PCModder803/fw16-mxm-adapter/mechanical/README.md

# Printed bottom frame mockup (not for print yet)

- `printed_frame_mockup.step`: the frame as a solid, in the coordinates of Framework's graphics-module
  assembly, so it overlays `FW_GRAPHICS_MODULE_REF_00-1.stp`.
- `printed_frame_mockup.stl`: the same, meshed (binary, watertight).
- `preview/`: renders, with the adapter board (green), MXM socket (red), ear pads (yellow) and card
  (blue) where shown.

They are generated by `../generate_frame.py`; see `../FRAME_PLAN.md` for what was changed, the fit
check, and what to check before printing.

## Licence and credit

These files are a modified version of the graphics-module bottom frame (IFGP6_DIS_FRAME_BTM) from
Framework Computer's FrameworkComputer/ExpansionBay repository, licensed under CC BY 4.0
(https://creativecommons.org/licenses/by/4.0/). Changes:
- lengthened by 3.7 mm at the rear over the full width (the rear wall, its vents and the corners moved
  back unchanged);
- the cover-screw bosses moved;
- the rear-wall ribs trimmed;
- two frame pins and a small front-left lip removed;
- one locating pin cut flush.

These files are licensed CC BY 4.0, not under the repository's CERN-OHL-S. Framework Computer does not
endorse this project.
