PCModder803/fw16-mxm-adapter/mechanical/preview/frame_iso.png

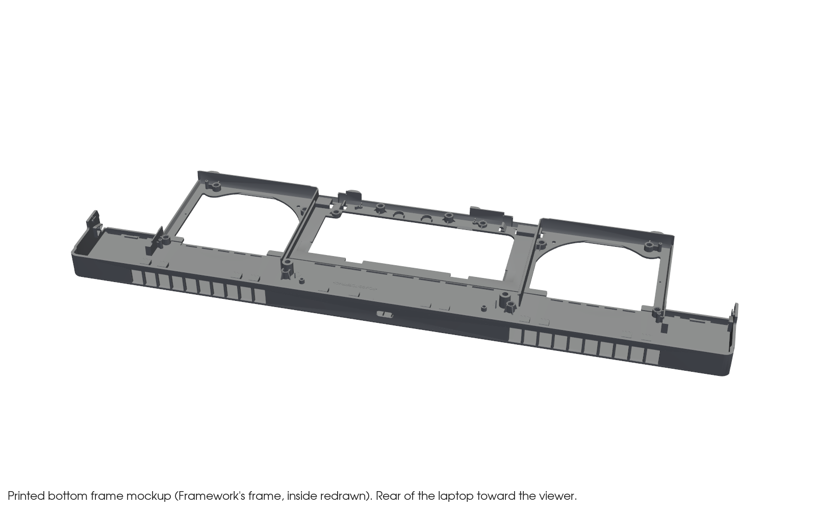
mechanical/preview/frame_iso.png
