PCModder803/fw16-mxm-adapter/mechanical/preview/frame_iso_with_card.png

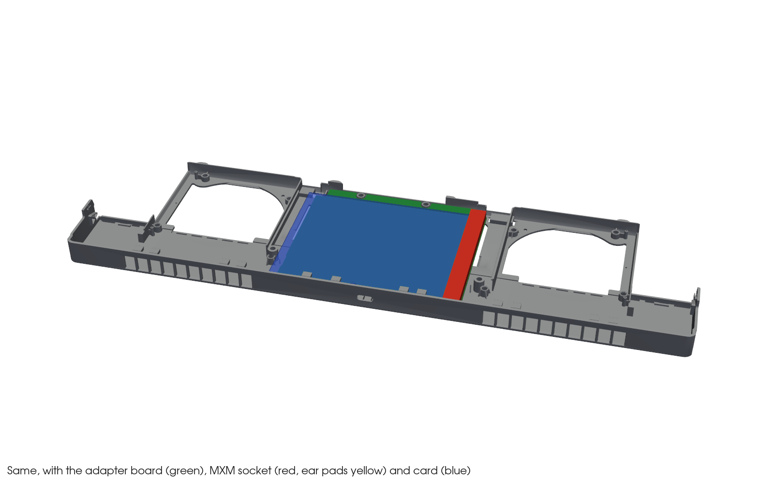
mechanical/preview/frame_iso_with_card.png
