PCModder803/fw16-mxm-adapter/mechanical/preview/frame_top.png

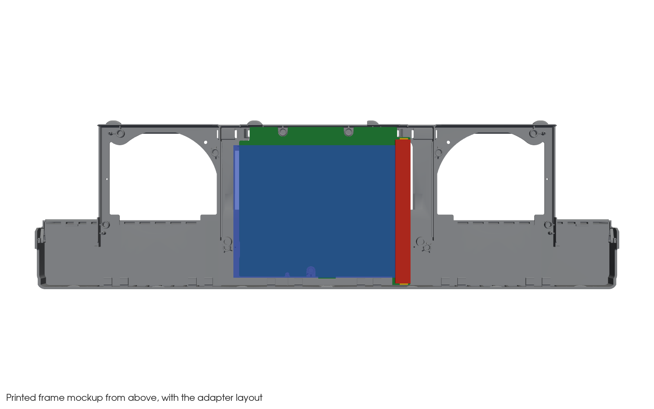
mechanical/preview/frame_top.png
