PCModder803/fw16-mxm-adapter/mechanical/preview/rear_left.png

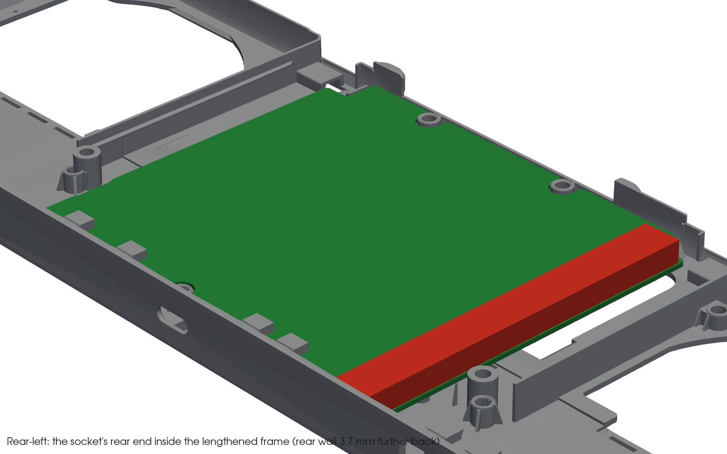
mechanical/preview/rear_left.png
