PCModder803/fw16-mxm-adapter/mechanical/preview/rear_outside.png

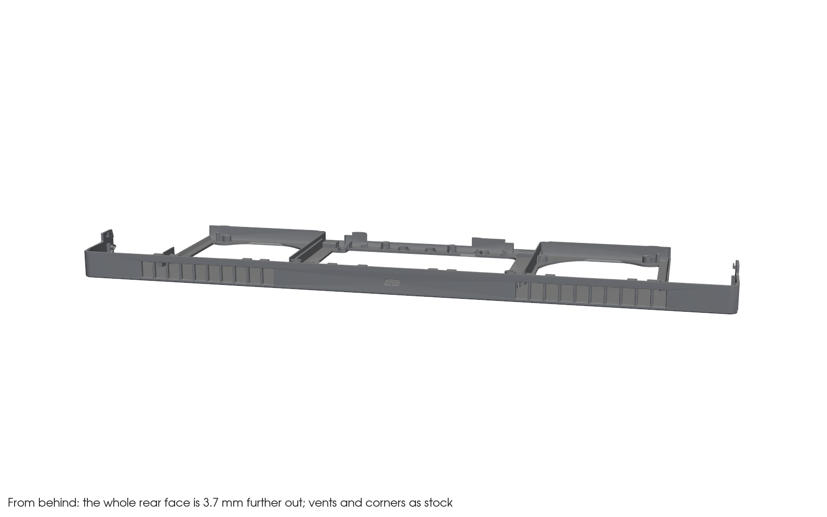
mechanical/preview/rear_outside.png
