PCModder803/fw16-mxm-adapter/reference/card_photos/efxdp1_riser_holes_labeled.jpg

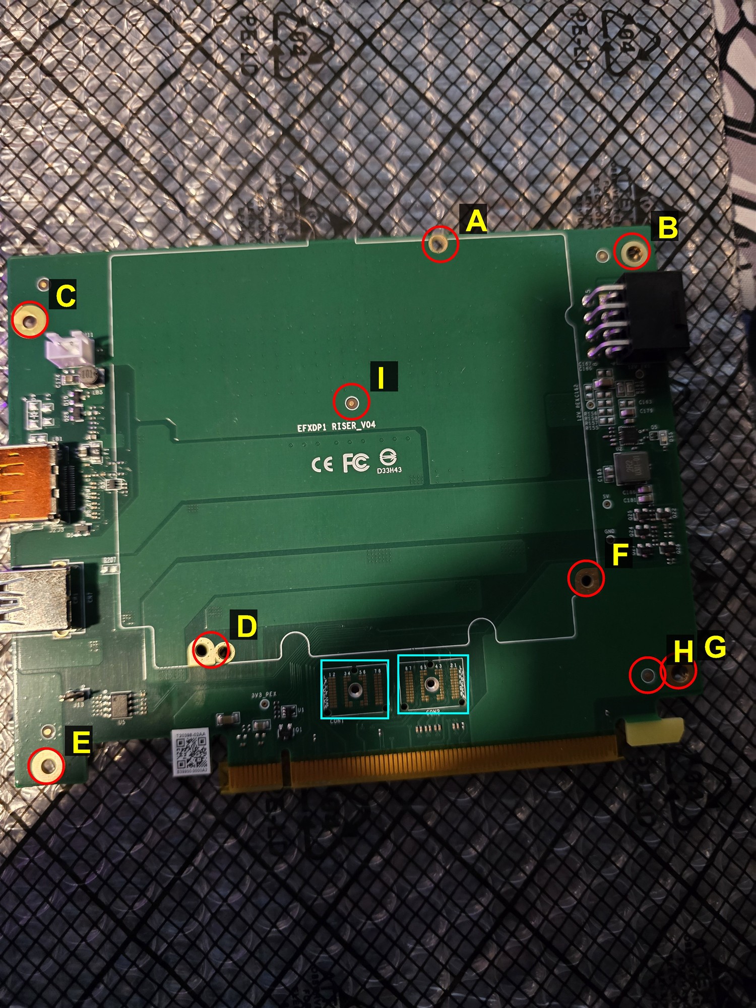
reference/card_photos/efxdp1_riser_holes_labeled.jpg
