PCModder803/fw16-mxm-adapter/reference/card_photos/xvision_rx6600xt_back.jpg

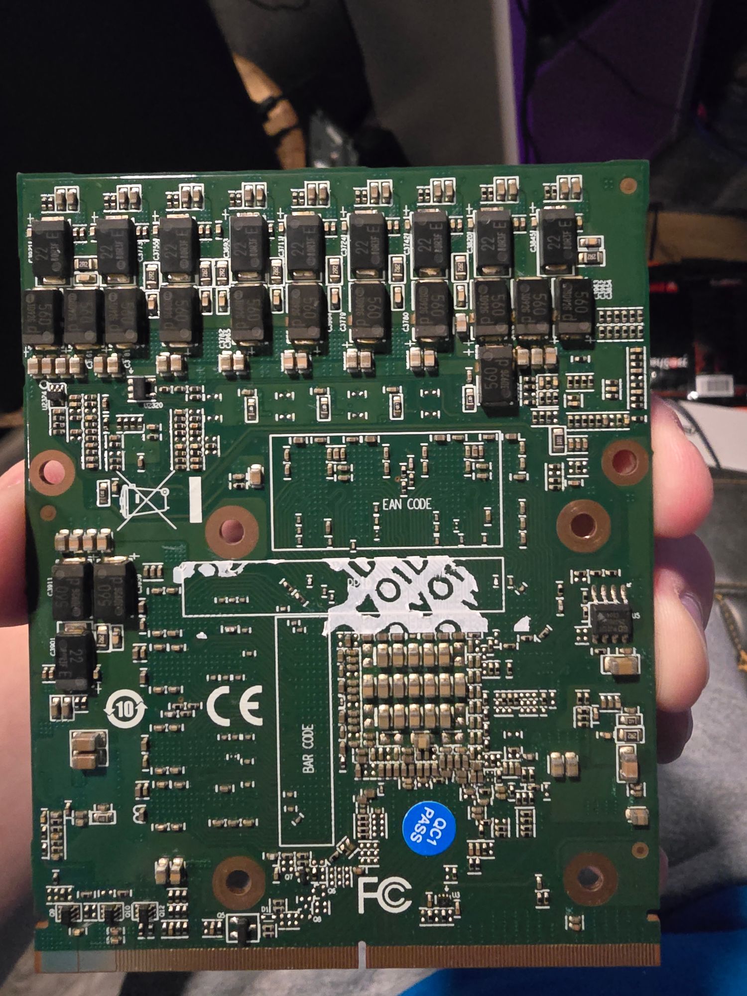
reference/card_photos/xvision_rx6600xt_back.jpg
