PCModder803/fw16-mxm-adapter/mechanical/printed_frame_mockup.step

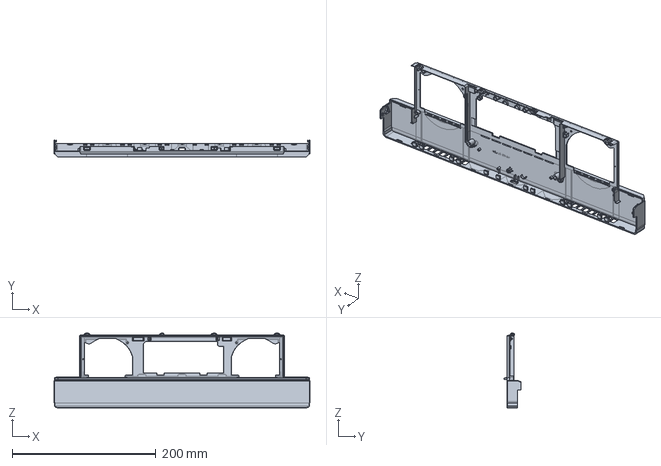
[picture p14: CAD file, 2026-11-12]
mechanical/printed_frame_mockup.step
356.6 x 24.1 x 104.0 mm
