PCModder803/fw16-mxm-adapter/(list of files, cad)

Other CAD files:
mechanical/printed_frame_mockup.stl
