PCModder803/fw16-mxm-adapter/fw16_mxm_adapter_pcb_draft.pdf

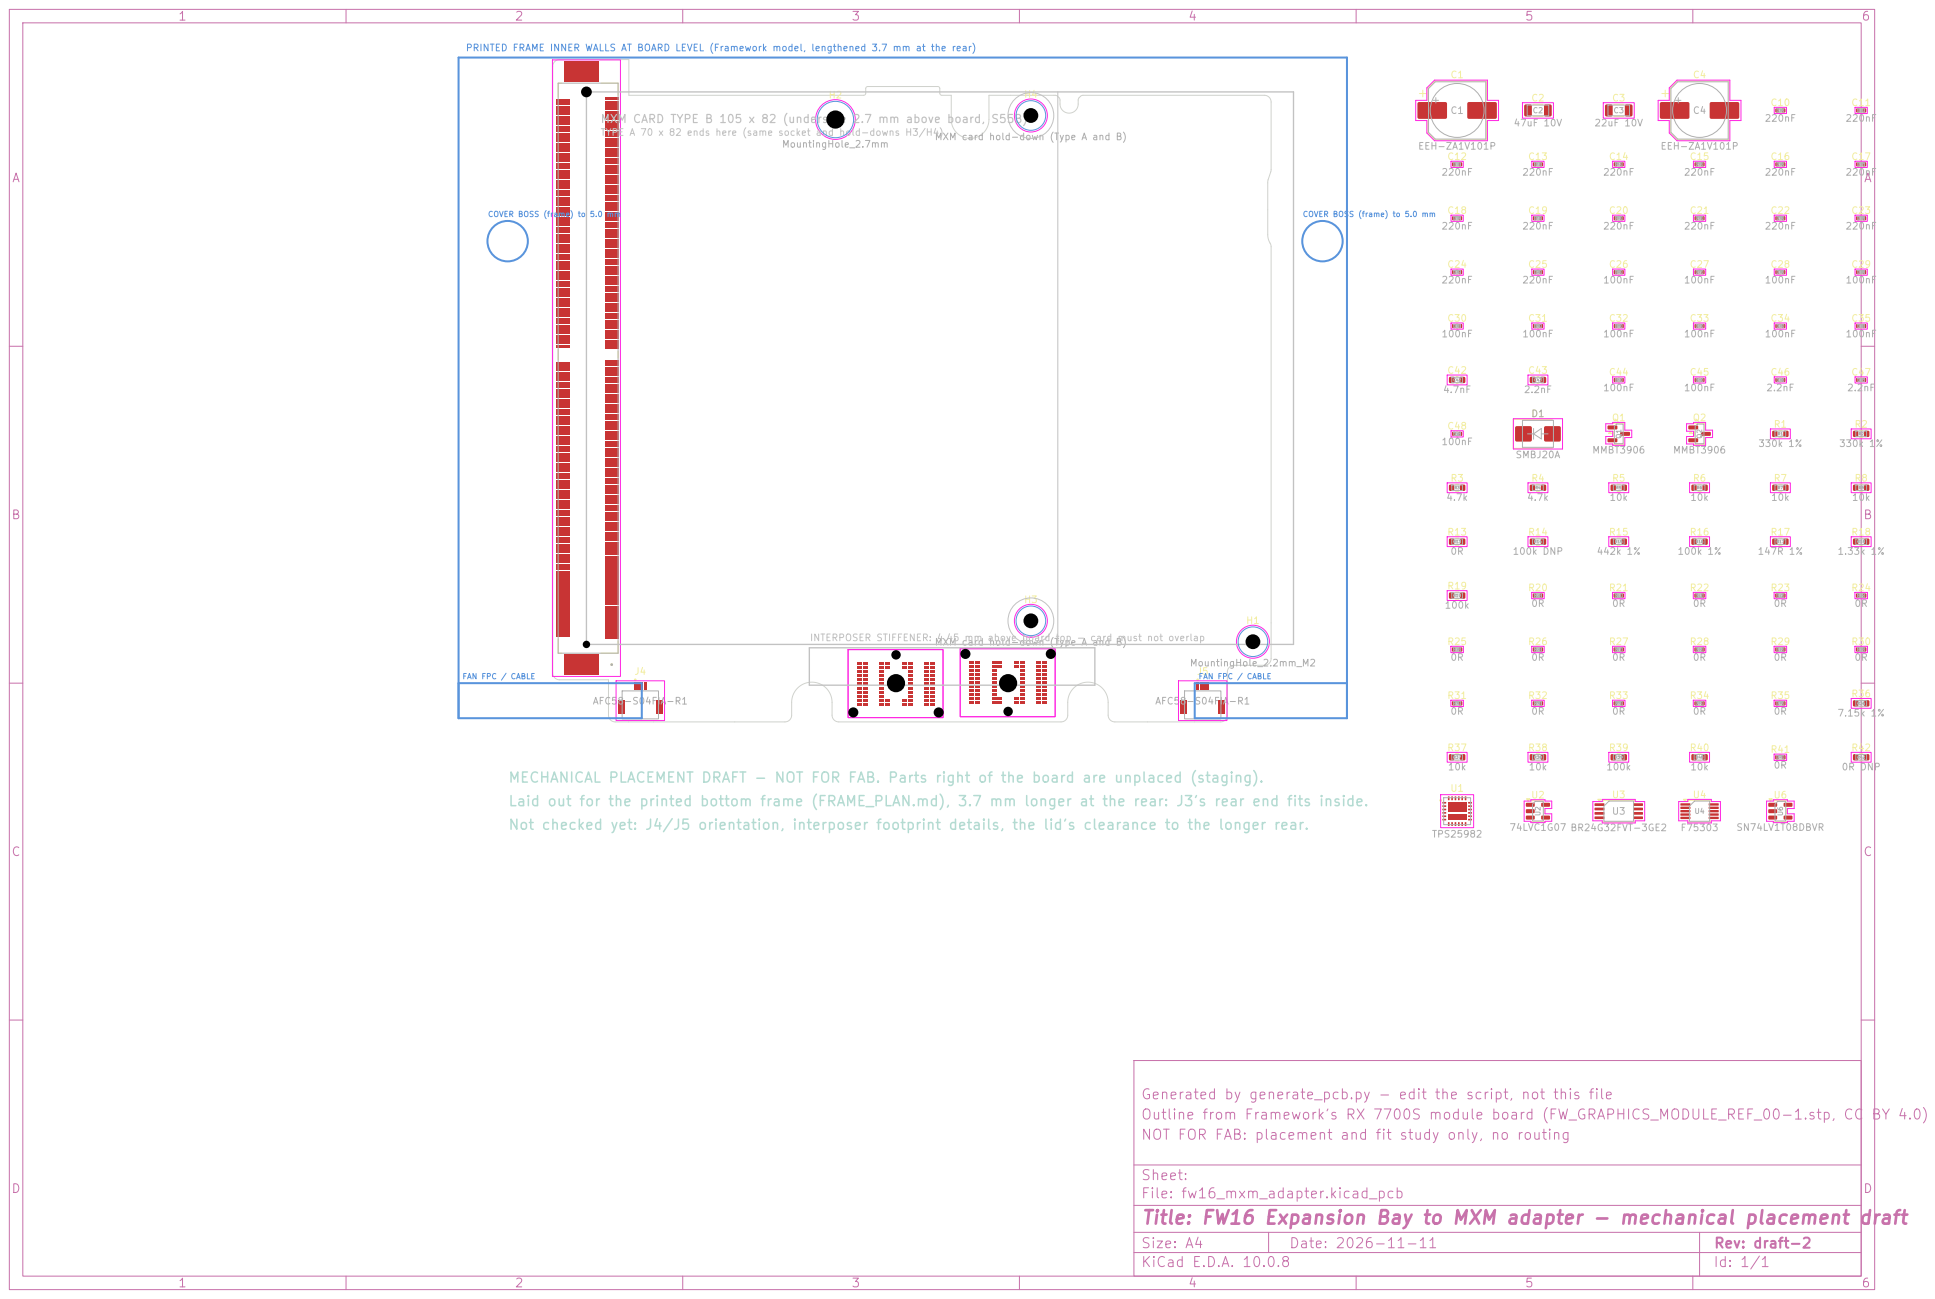
[picture p16: page 1]

PRINTED FRAME INNER WALLS AT BOARD LEVEL (Framework model, lengthened 3.7 mm at the rear)

TYPE A 70 x 82 ends here (same socket and hold-downs H3/H4)

C27 MXM card hold-down (Type A and B) H4

COVER BOSS (frame) to 5.0 mm

C24 MXM card hold-down (Type A and B) H3

MECHANICAL PLACEMENT DRAFT - NOT FOR FAB. Parts right of the board are unplaced (staging).
Laid out for the printed bottom frame (FRAME_PLAN.md), 3.7 mm longer at the rear: J3's rear end fits inside.
Not checked yet: J4/J5 orientation, interposer footprint details, the lid's clearance to the longer rear.

Generated by generate_pcb.py - edit the script, not this file
Outline from Framework's RX 7700S module board (FW_GRAPHICS_MODULE_REF_00-1.stp, CC BY 4.0)
NOT FOR FAB: placement and fit study only, no routing

Sheet:
File: fw16_mxm_adapter.kicad_pcb
Title: FW16 Expansion Bay to MXM adapter - mechanical placement draft

Size: A4 | Rev: draft-2
KiCad E.D.A. 10.0.8 | Id: 1/1
