PCModder803/fw16-mxm-adapter/fw16_mxm_adapter.kicad_pcb

## KiCad design fw16_mxm_adapter.kicad_pcb (2026-11-12)

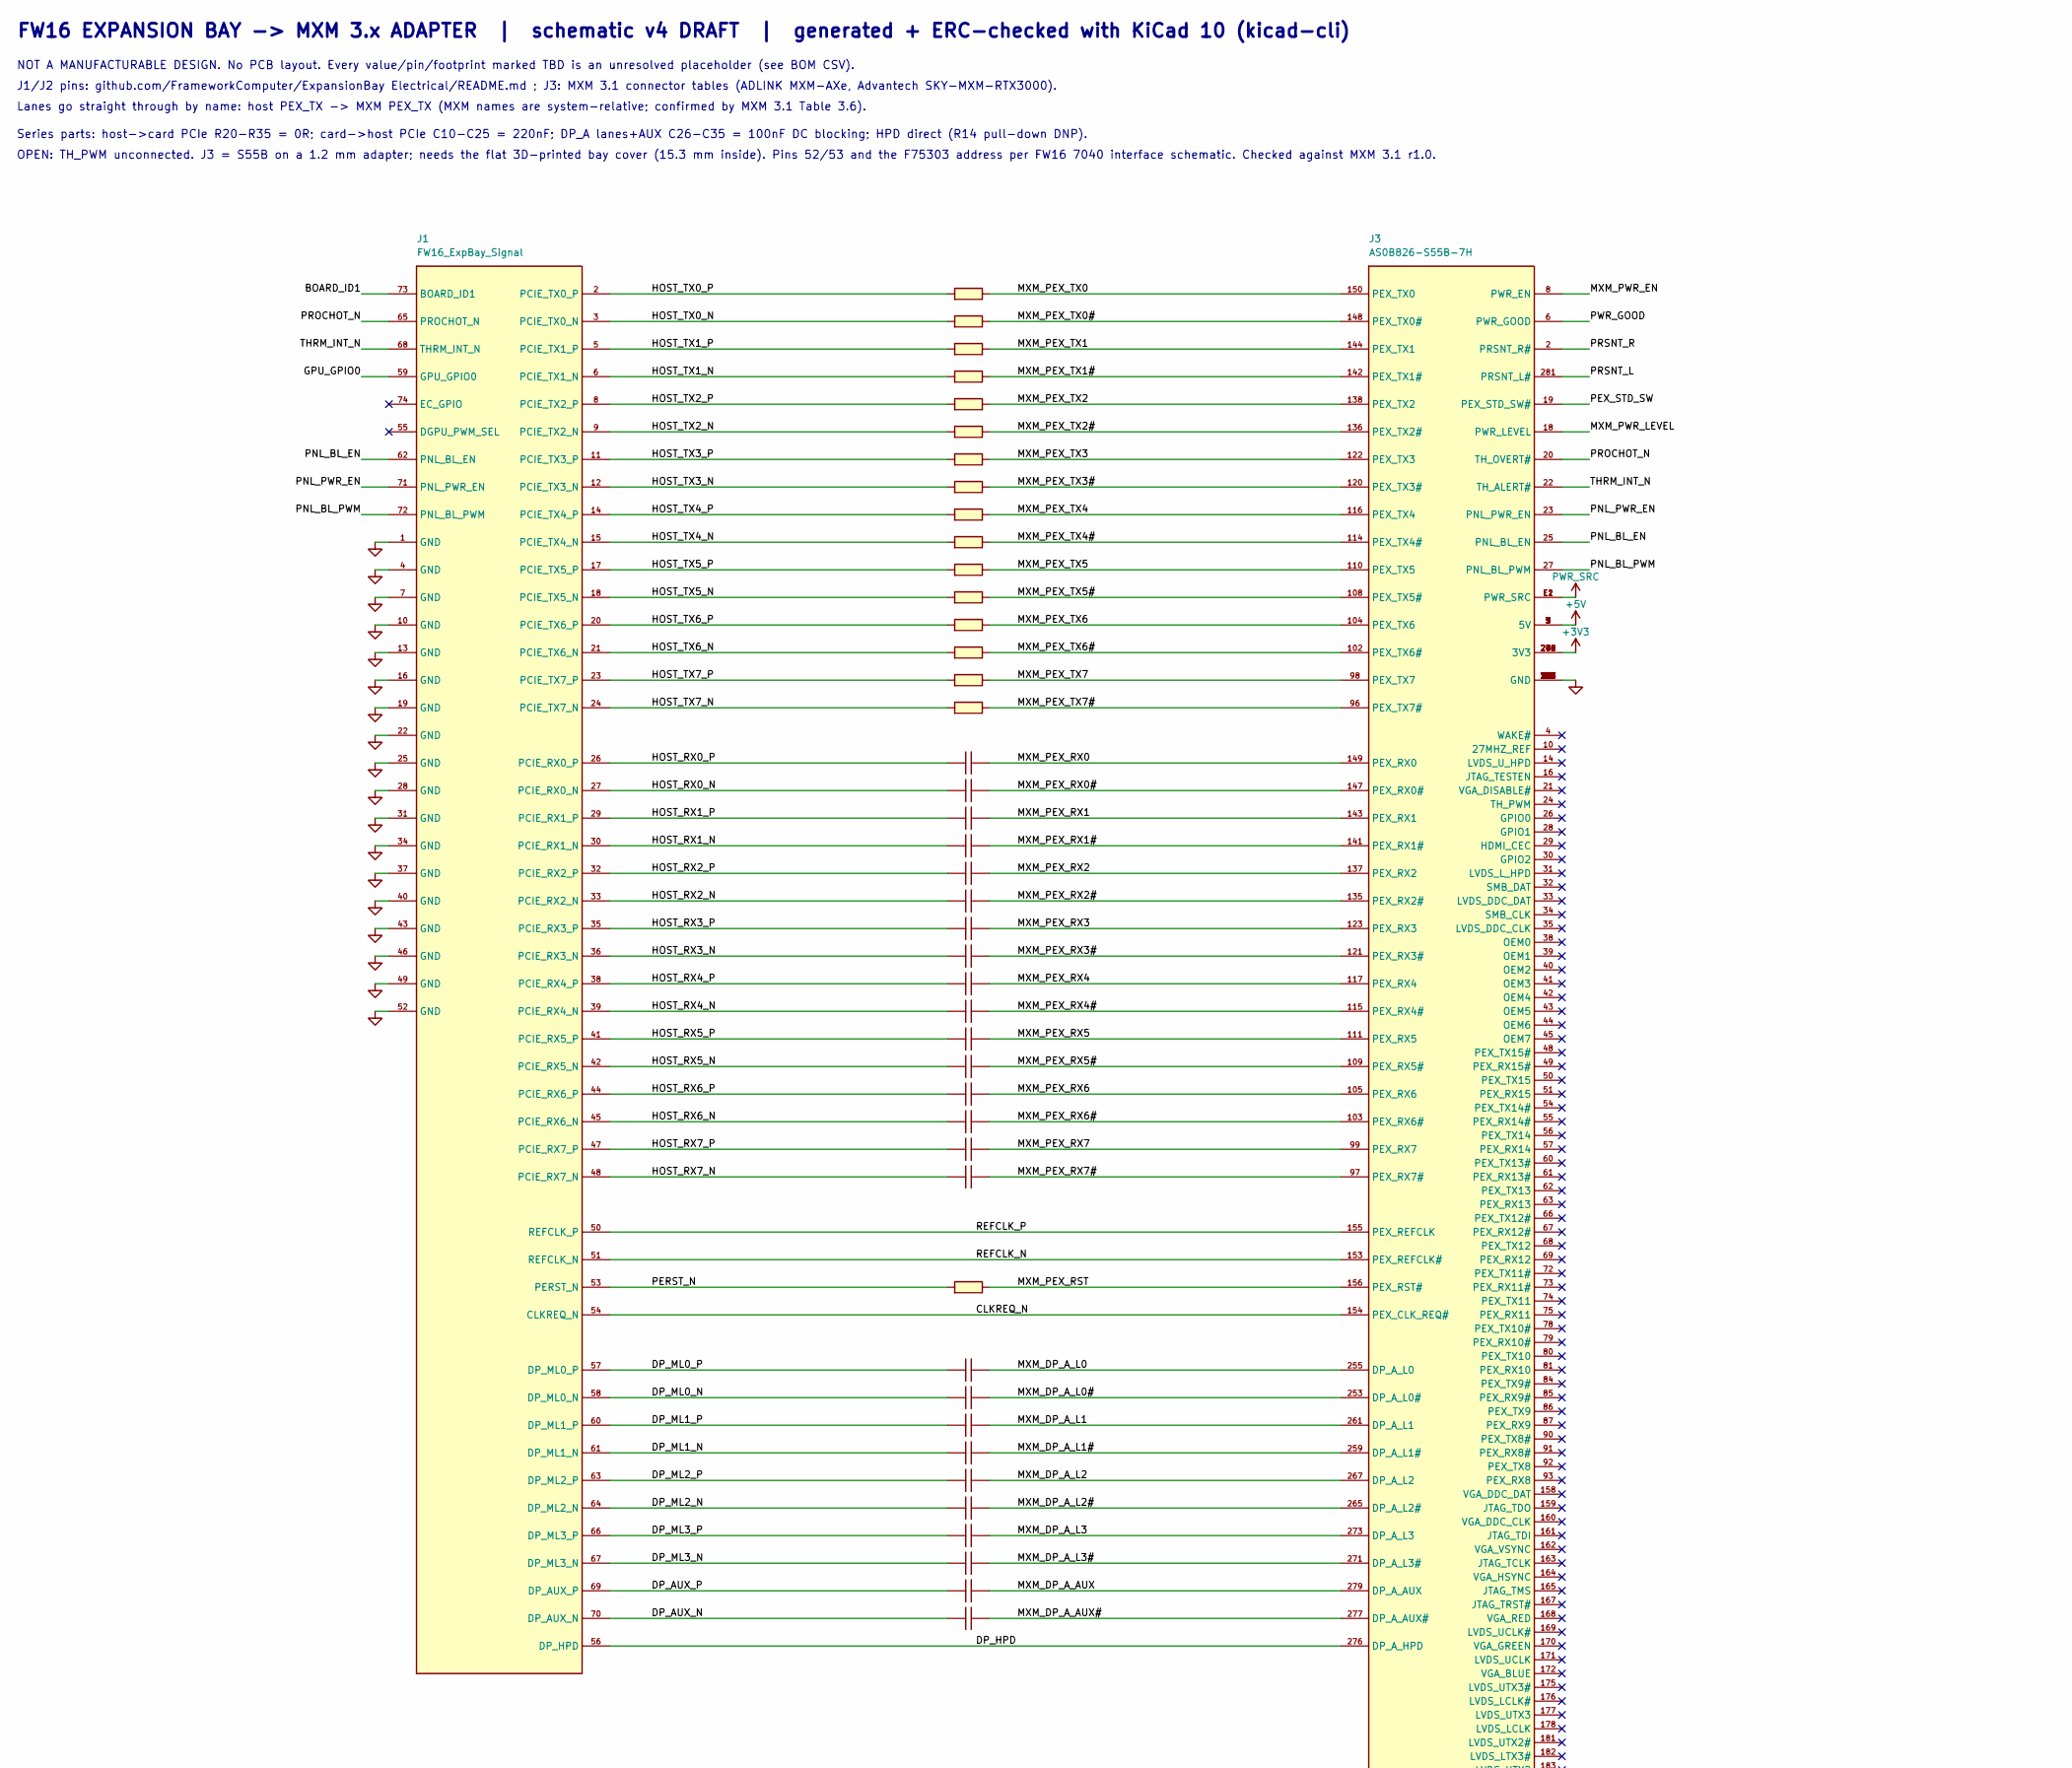
[picture p17: schematic fw16_mxm_adapter.kicad_sch, Framework 16 Expansion Bay to MXM 3.x Adapter, part in row 1, column 1]

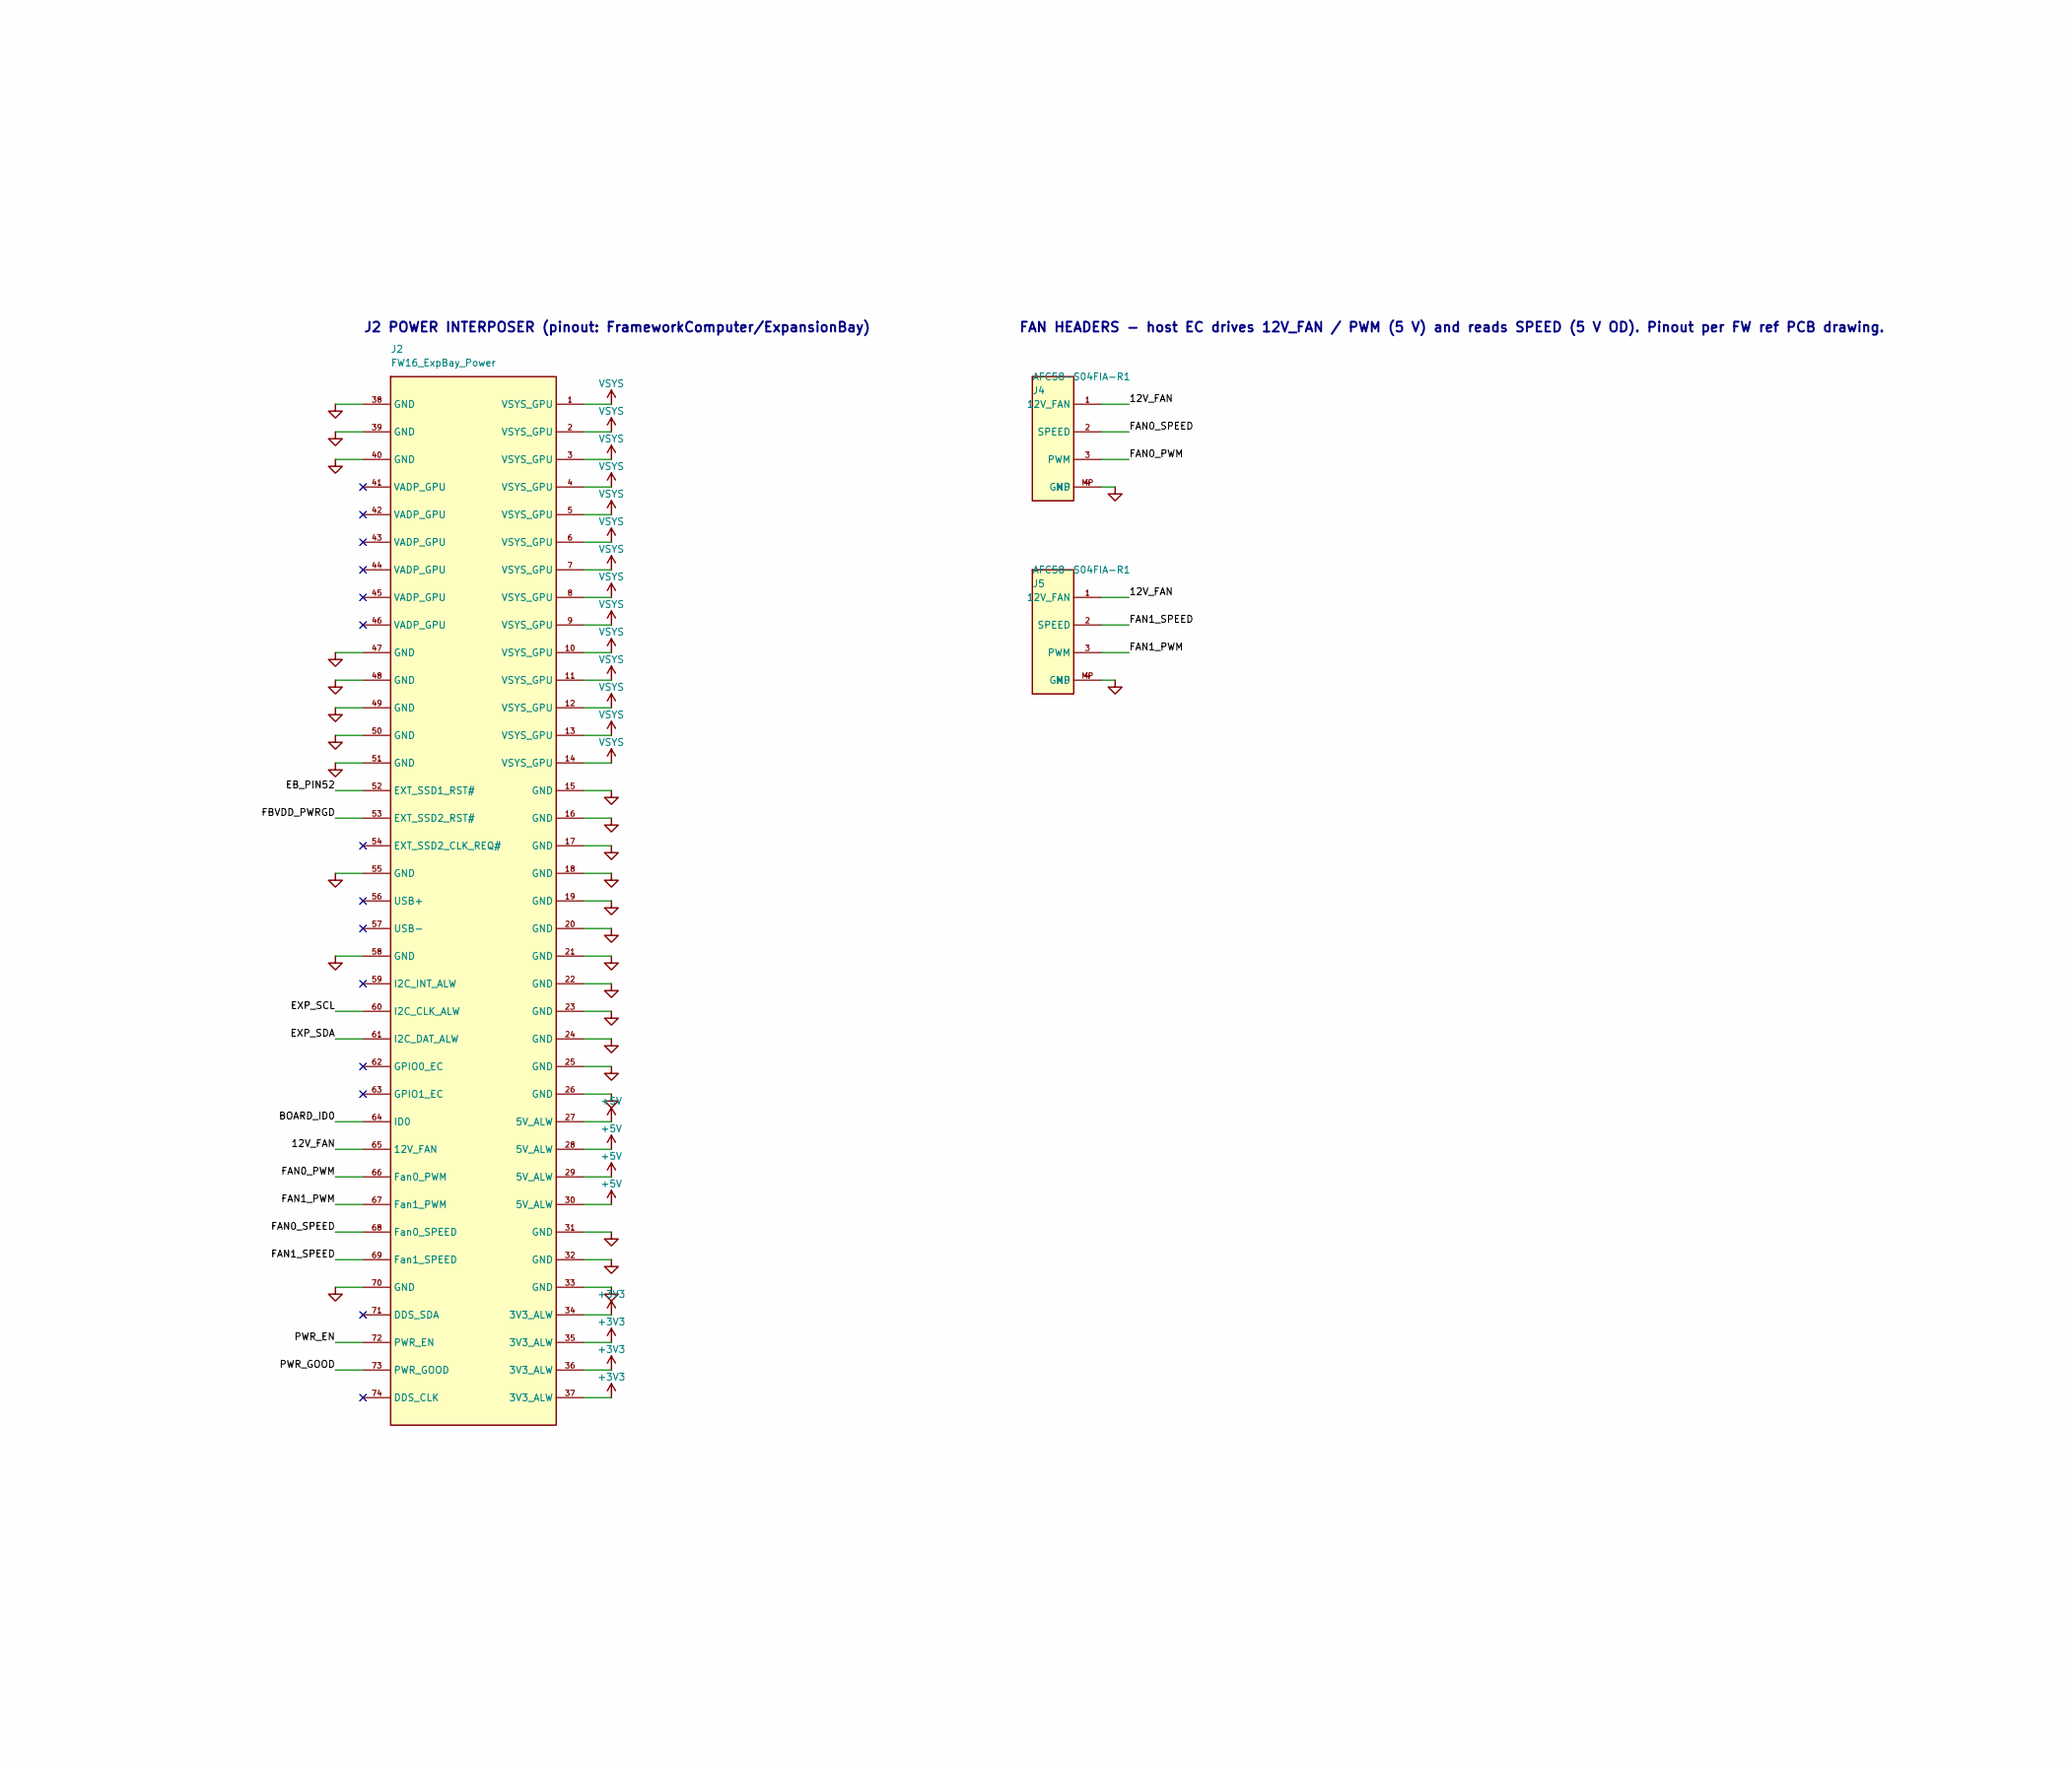
[picture p18: schematic fw16_mxm_adapter.kicad_sch, Framework 16 Expansion Bay to MXM 3.x Adapter, part in row 1, column 2]

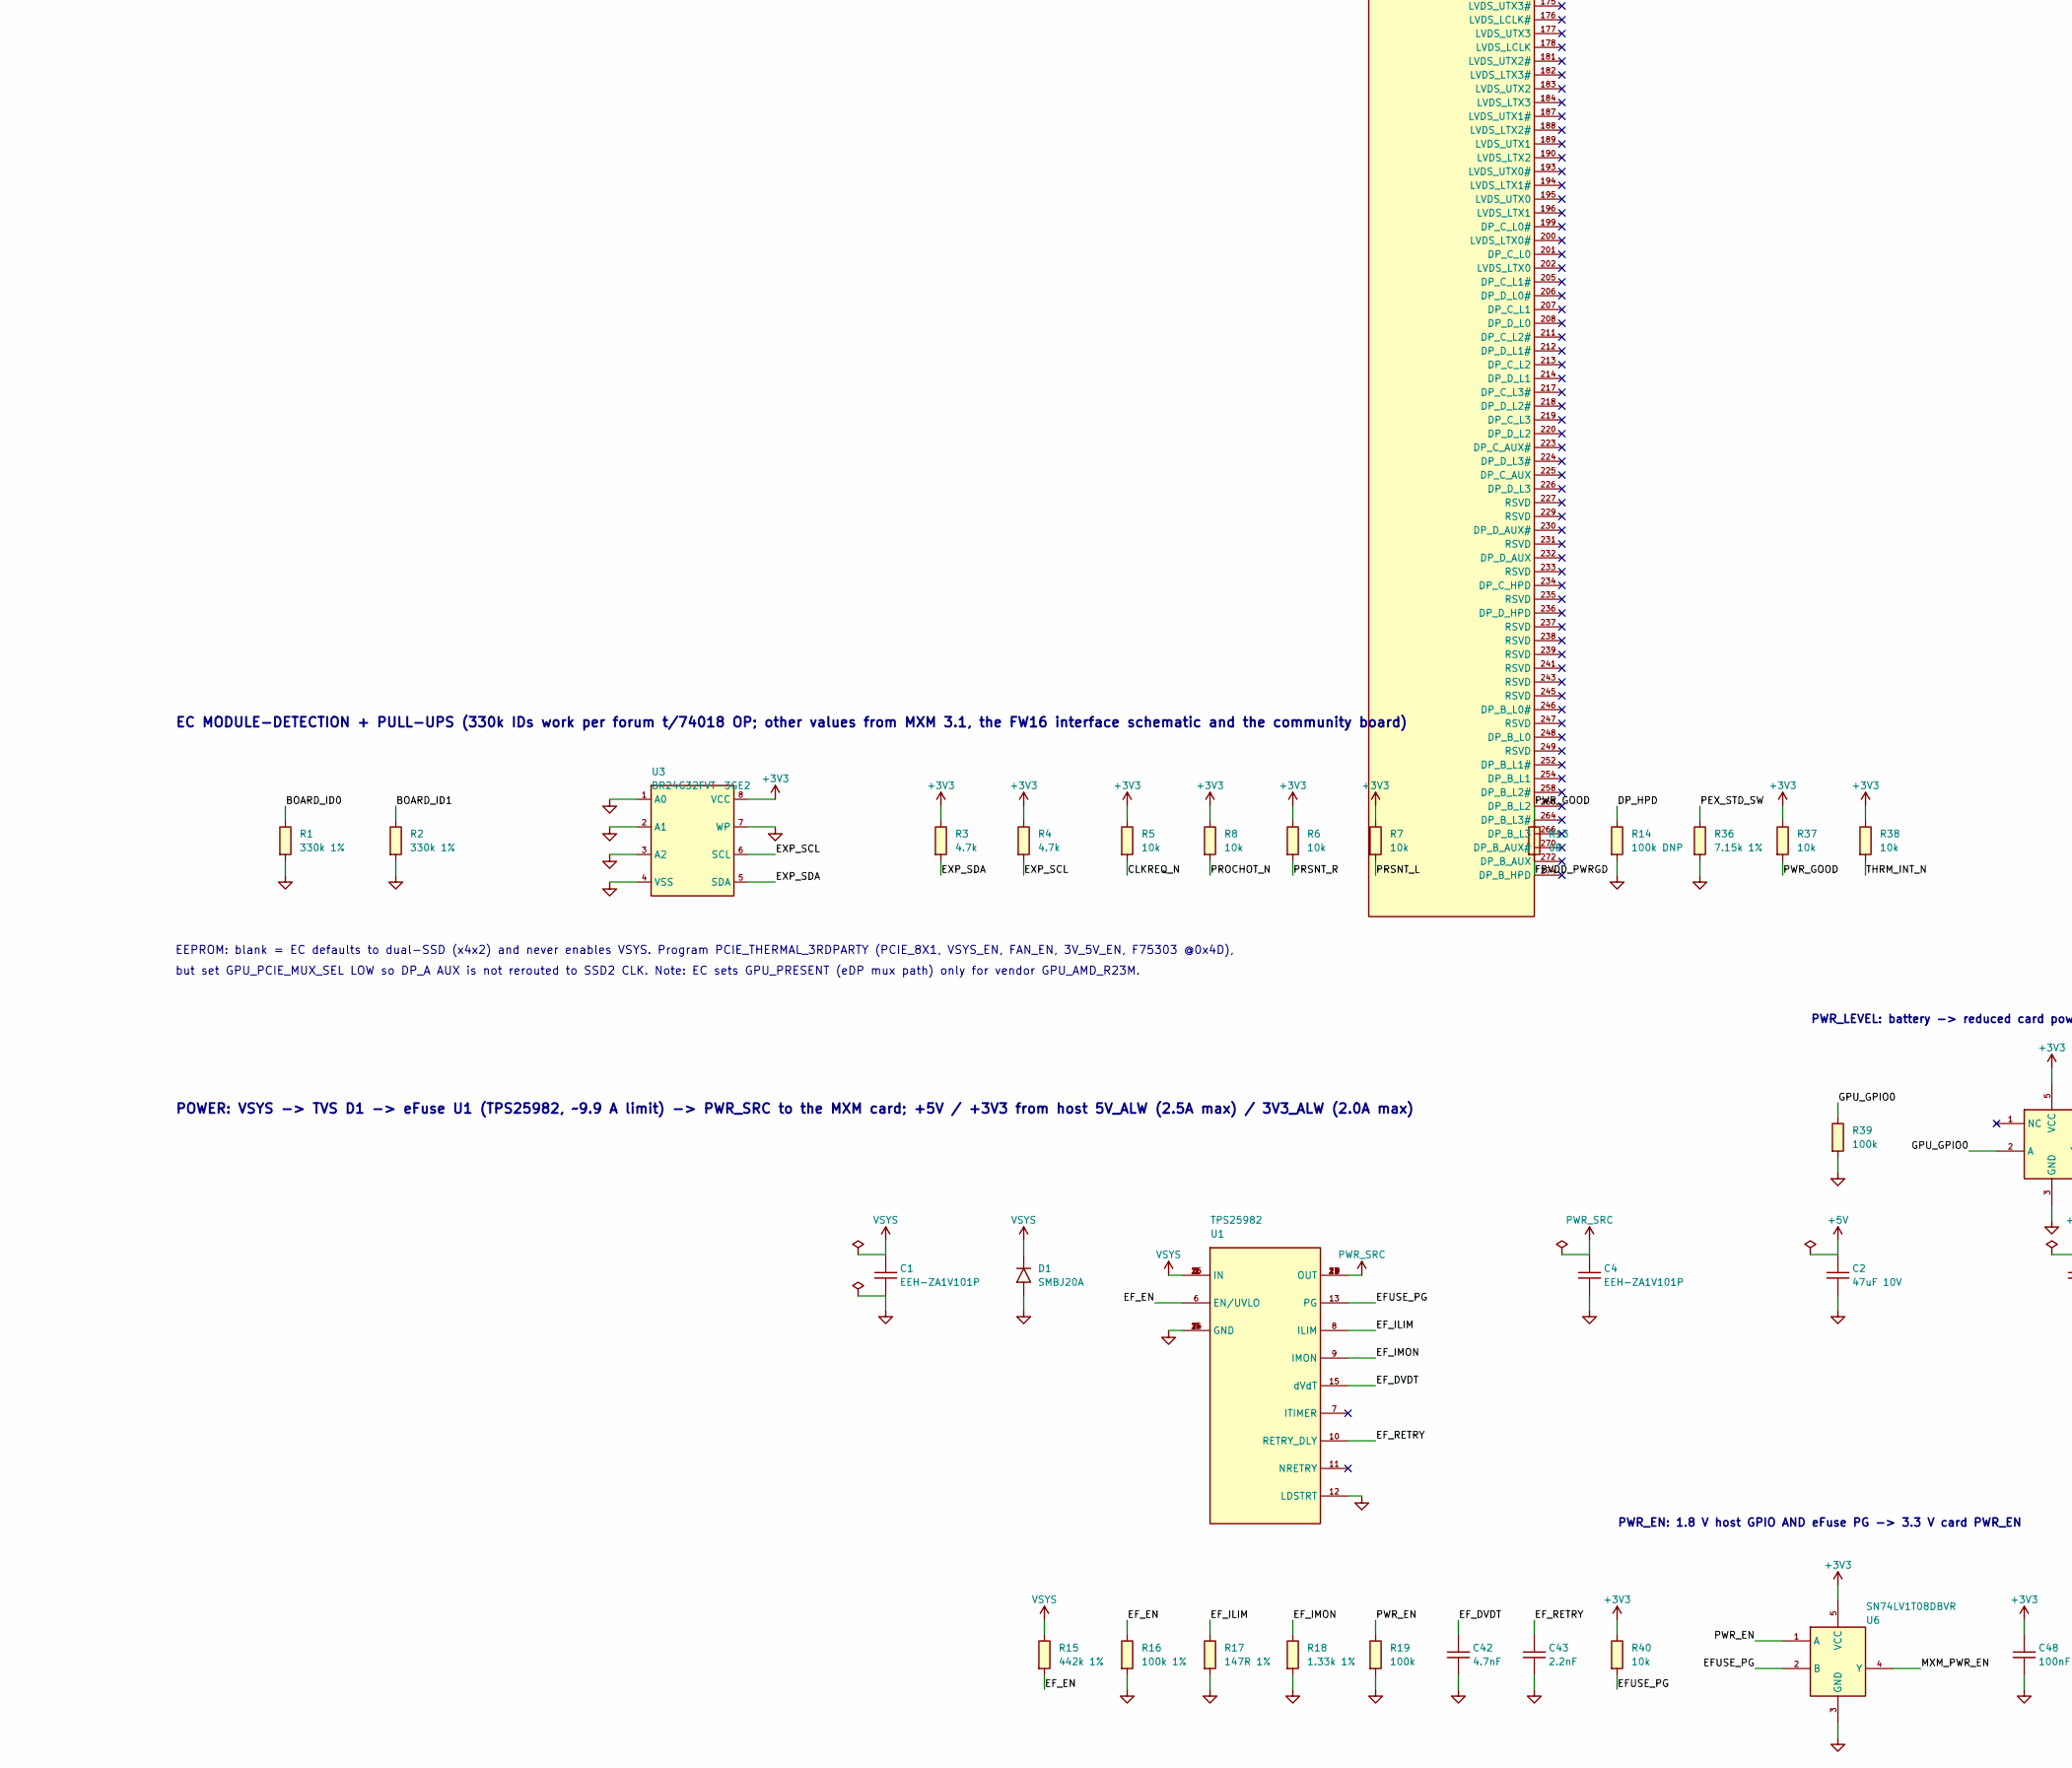
[picture p19: schematic fw16_mxm_adapter.kicad_sch, Framework 16 Expansion Bay to MXM 3.x Adapter, part in row 2, column 1]

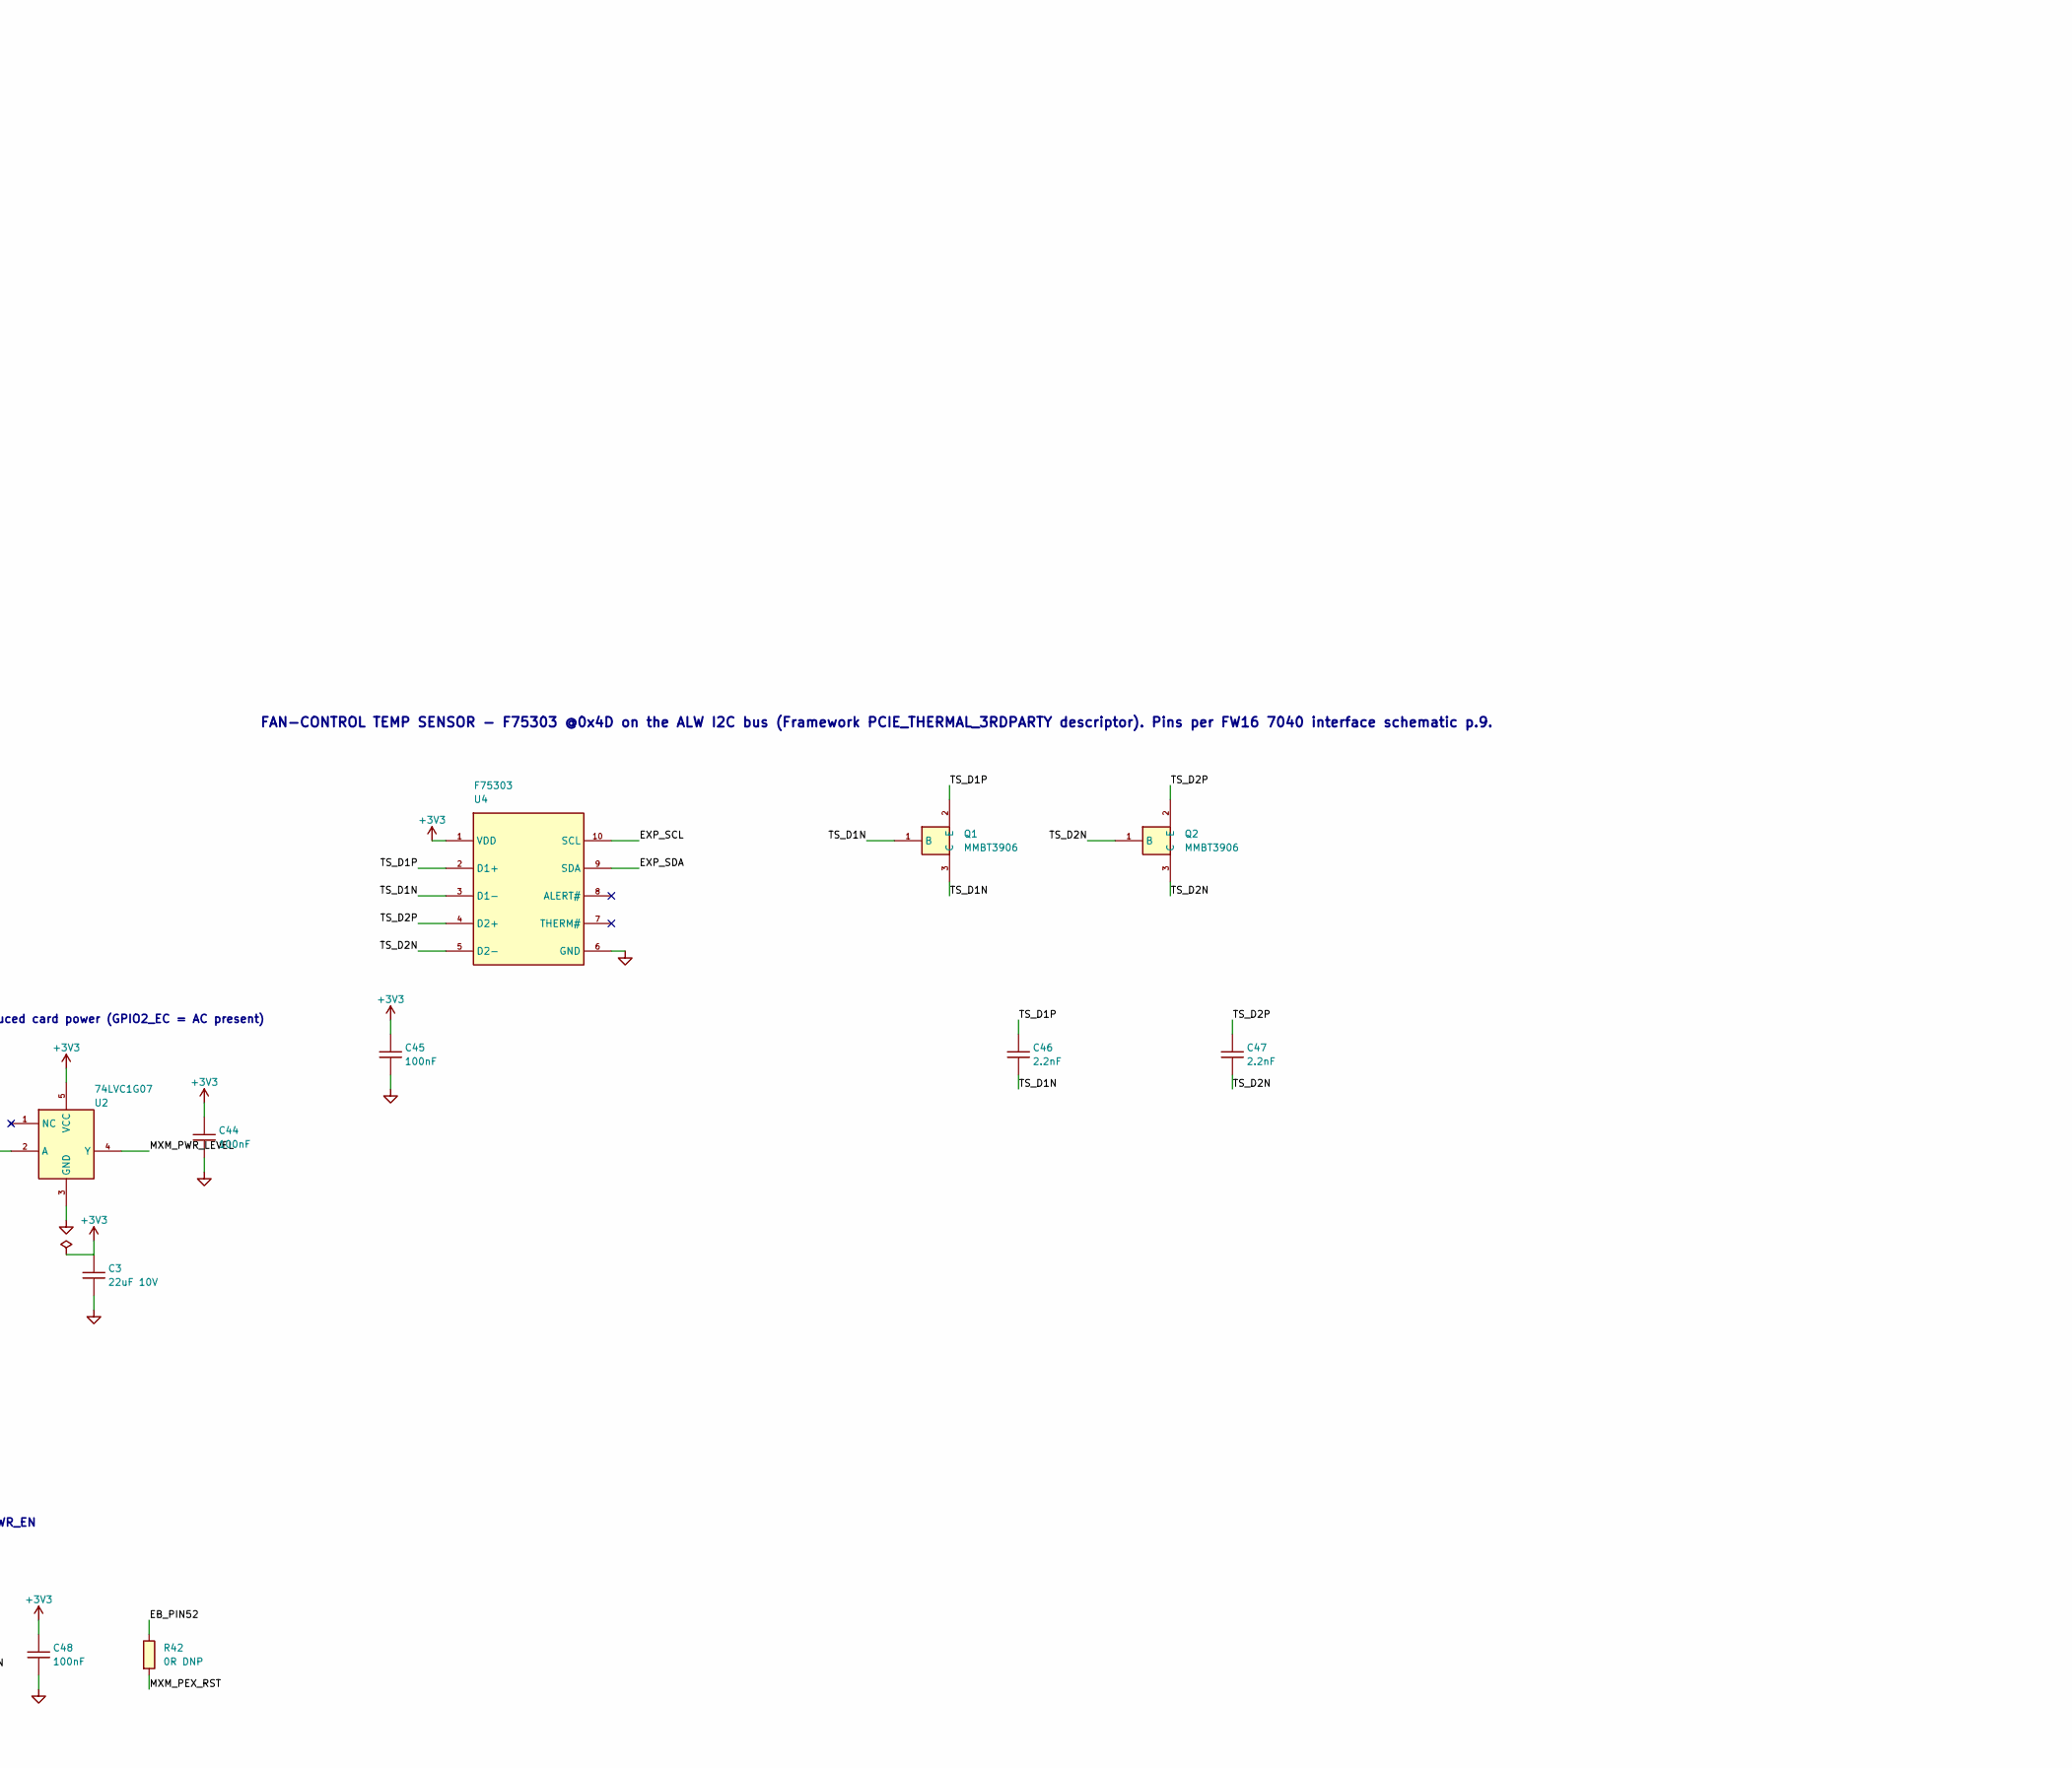
[picture p20: schematic fw16_mxm_adapter.kicad_sch, Framework 16 Expansion Bay to MXM 3.x Adapter, part in row 2, column 2]

Parts:
C1, C4: EEH-ZA1V101P; CP_Elec_8x10.5
C2: 47uF 10V; C_1206_3216Metric
C3: 22uF 10V; C_1206_3216Metric
C10, C11, C12, C13, C14, C15, C16, C17, C18, C19, C20, C21, C22, C23, C24, C25: 220nF; C_0402_1005Metric
C26, C27, C28, C29, C30, C31, C32, C33, C34, C35, C44, C45, C48: 100nF; C_0402_1005Metric
C42: 4.7nF; C_0603_1608Metric
C43: 2.2nF; C_0603_1608Metric
C46, C47: 2.2nF; C_0402_1005Metric
D1: SMBJ20A; D_SMB
J1: FW16_ExpBay_Signal; FW16_FXBeam_Signal
J2: FW16_ExpBay_Power; FW16_FXBeam_Power
J3: AS0B826-S55B-7H; MXM3_AS0B826-S55B-7H
J4, J5: AFC58-S04FIA-R1; Hefeng_AFC58-S04F_1x04_P0.5mm_Horizontal
Q1, Q2: MMBT3906; SOT-23
R1, R2: 330k 1%; R_0603_1608Metric
R3, R4: 4.7k; R_0603_1608Metric
R5, R6, R7, R8, R37, R38, R40: 10k; R_0603_1608Metric
R13: 0R; R_0603_1608Metric
R14: 100k DNP; R_0603_1608Metric
R15: 442k 1%; R_0603_1608Metric
R16: 100k 1%; R_0603_1608Metric
R17: 147R 1%; R_0603_1608Metric
R18: 1.33k 1%; R_0603_1608Metric
R19, R39: 100k; R_0603_1608Metric
R20, R21, R22, R23, R24, R25, R26, R27, R28, R29, R30, R31, R32, R33, R34, R35, R41: 0R; R_0402_1005Metric
R36: 7.15k 1%; R_0603_1608Metric
R42: 0R DNP; R_0603_1608Metric
U1: TPS25982; TI_RGE0024M_VQFN-24_4x4mm_P0.5mm_2EP
U2: 74LVC1G07; SOT-23-5
U3: BR24G32FVT-3GE2; TSSOP-8_4.4x3mm_P0.65mm
U4: F75303; MSOP-10_3x3mm_P0.5mm
U6: SN74LV1T08DBVR; SOT-23-5

Connections:
+3V3: C3.1, C44.1, C45.1, C48.1, J2.34 (3V3_ALW), J2.35 (3V3_ALW), J2.36 (3V3_ALW), J2.37 (3V3_ALW), J3.240 (3V3), J3.242 (3V3), J3.278 (3V3), J3.280 (3V3), R3.1, R4.1, R5.1, R6.1, R7.1, R8.1, R37.1, R38.1, R40.1, U2.5 (VCC), U3.8 (VCC), U4.1 (VDD), U6.5 (VCC)
+5V: C2.1, J2.27 (5V_ALW), J2.28 (5V_ALW), J2.29 (5V_ALW), J2.30 (5V_ALW), J3.1 (5V), J3.3 (5V), J3.5 (5V), J3.7 (5V), J3.9 (5V)
/12V_FAN: J2.65 (12V_FAN), J4.1 (12V_FAN), J5.1 (12V_FAN)
/BOARD_ID0: J2.64 (ID0), R1.1
/BOARD_ID1: J1.73 (BOARD_ID1), R2.1
/CLKREQ_N: J1.54 (CLKREQ_N), J3.154 (PEX_CLK_REQ#), R5.2
/DP_AUX_N: C35.1, J1.70 (DP_AUX_N)
/DP_AUX_P: C34.1, J1.69 (DP_AUX_P)
/DP_HPD: J1.56 (DP_HPD), J3.276 (DP_A_HPD), R14.1
/DP_ML0_N: C27.1, J1.58 (DP_ML0_N)
/DP_ML0_P: C26.1, J1.57 (DP_ML0_P)
/DP_ML1_N: C29.1, J1.61 (DP_ML1_N)
/DP_ML1_P: C28.1, J1.60 (DP_ML1_P)
/DP_ML2_N: C31.1, J1.64 (DP_ML2_N)
/DP_ML2_P: C30.1, J1.63 (DP_ML2_P)
/DP_ML3_N: C33.1, J1.67 (DP_ML3_N)
/DP_ML3_P: C32.1, J1.66 (DP_ML3_P)
/EB_PIN52: J2.52 (EXT_SSD1_RST#), R42.1
/EFUSE_PG: R40.2, U1.13 (PG), U6.2 (B)
/EF_DVDT: C42.1, U1.15 (dVdT)
/EF_EN: R15.2, R16.1, U1.6 (EN/UVLO)
/EF_ILIM: R17.1, U1.8 (ILIM)
/EF_IMON: R18.1, U1.9 (IMON)
/EF_RETRY: C43.1, U1.10 (RETRY_DLY)
/EXP_SCL: J2.60 (I2C_CLK_ALW), R4.2, U3.6 (SCL), U4.10 (SCL)
/EXP_SDA: J2.61 (I2C_DAT_ALW), R3.2, U3.5 (SDA), U4.9 (SDA)
/FAN0_PWM: J2.66 (Fan0_PWM), J4.3 (PWM)
/FAN0_SPEED: J2.68 (Fan0_SPEED), J4.2 (SPEED)
/FAN1_PWM: J2.67 (Fan1_PWM), J5.3 (PWM)
/FAN1_SPEED: J2.69 (Fan1_SPEED), J5.2 (SPEED)
/FBVDD_PWRGD: J2.53 (EXT_SSD2_RST#), R13.2
/GPU_GPIO0: J1.59 (GPU_GPIO0), R39.1, U2.2 (A)
/HOST_RX0_N: C11.1, J1.27 (PCIE_RX0_N)
/HOST_RX0_P: C10.1, J1.26 (PCIE_RX0_P)
/HOST_RX1_N: C13.1, J1.30 (PCIE_RX1_N)
/HOST_RX1_P: C12.1, J1.29 (PCIE_RX1_P)
/HOST_RX2_N: C15.1, J1.33 (PCIE_RX2_N)
/HOST_RX2_P: C14.1, J1.32 (PCIE_RX2_P)
/HOST_RX3_N: C17.1, J1.36 (PCIE_RX3_N)
/HOST_RX3_P: C16.1, J1.35 (PCIE_RX3_P)
/HOST_RX4_N: C19.1, J1.39 (PCIE_RX4_N)
/HOST_RX4_P: C18.1, J1.38 (PCIE_RX4_P)
/HOST_RX5_N: C21.1, J1.42 (PCIE_RX5_N)
/HOST_RX5_P: C20.1, J1.41 (PCIE_RX5_P)
/HOST_RX6_N: C23.1, J1.45 (PCIE_RX6_N)
/HOST_RX6_P: C22.1, J1.44 (PCIE_RX6_P)
/HOST_RX7_N: C25.1, J1.48 (PCIE_RX7_N)
/HOST_RX7_P: C24.1, J1.47 (PCIE_RX7_P)
/HOST_TX0_N: J1.3 (PCIE_TX0_N), R21.1
/HOST_TX0_P: J1.2 (PCIE_TX0_P), R20.1
/HOST_TX1_N: J1.6 (PCIE_TX1_N), R23.1
/HOST_TX1_P: J1.5 (PCIE_TX1_P), R22.1
/HOST_TX2_N: J1.9 (PCIE_TX2_N), R25.1
/HOST_TX2_P: J1.8 (PCIE_TX2_P), R24.1
/HOST_TX3_N: J1.12 (PCIE_TX3_N), R27.1
/HOST_TX3_P: J1.11 (PCIE_TX3_P), R26.1
/HOST_TX4_N: J1.15 (PCIE_TX4_N), R29.1
/HOST_TX4_P: J1.14 (PCIE_TX4_P), R28.1
/HOST_TX5_N: J1.18 (PCIE_TX5_N), R31.1
/HOST_TX5_P: J1.17 (PCIE_TX5_P), R30.1
/HOST_TX6_N: J1.21 (PCIE_TX6_N), R33.1
/HOST_TX6_P: J1.20 (PCIE_TX6_P), R32.1
/HOST_TX7_N: J1.24 (PCIE_TX7_N), R35.1
/HOST_TX7_P: J1.23 (PCIE_TX7_P), R34.1
/MXM_DP_A_AUX: C34.2, J3.279 (DP_A_AUX)
/MXM_DP_A_AUX#: C35.2, J3.277 (DP_A_AUX#)
/MXM_DP_A_L0: C26.2, J3.255 (DP_A_L0)
/MXM_DP_A_L0#: C27.2, J3.253 (DP_A_L0#)
/MXM_DP_A_L1: C28.2, J3.261 (DP_A_L1)
/MXM_DP_A_L1#: C29.2, J3.259 (DP_A_L1#)
/MXM_DP_A_L2: C30.2, J3.267 (DP_A_L2)
/MXM_DP_A_L2#: C31.2, J3.265 (DP_A_L2#)
/MXM_DP_A_L3: C32.2, J3.273 (DP_A_L3)
/MXM_DP_A_L3#: C33.2, J3.271 (DP_A_L3#)
/MXM_PEX_RST: J3.156 (PEX_RST#), R41.2, R42.2
/MXM_PEX_RX0: C10.2, J3.149 (PEX_RX0)
/MXM_PEX_RX0#: C11.2, J3.147 (PEX_RX0#)
/MXM_PEX_RX1: C12.2, J3.143 (PEX_RX1)
/MXM_PEX_RX1#: C13.2, J3.141 (PEX_RX1#)
/MXM_PEX_RX2: C14.2, J3.137 (PEX_RX2)
/MXM_PEX_RX2#: C15.2, J3.135 (PEX_RX2#)
/MXM_PEX_RX3: C16.2, J3.123 (PEX_RX3)
/MXM_PEX_RX3#: C17.2, J3.121 (PEX_RX3#)
/MXM_PEX_RX4: C18.2, J3.117 (PEX_RX4)
/MXM_PEX_RX4#: C19.2, J3.115 (PEX_RX4#)
/MXM_PEX_RX5: C20.2, J3.111 (PEX_RX5)
/MXM_PEX_RX5#: C21.2, J3.109 (PEX_RX5#)
/MXM_PEX_RX6: C22.2, J3.105 (PEX_RX6)
/MXM_PEX_RX6#: C23.2, J3.103 (PEX_RX6#)
/MXM_PEX_RX7: C24.2, J3.99 (PEX_RX7)
/MXM_PEX_RX7#: C25.2, J3.97 (PEX_RX7#)
/MXM_PEX_TX0: J3.150 (PEX_TX0), R20.2
/MXM_PEX_TX0#: J3.148 (PEX_TX0#), R21.2
/MXM_PEX_TX1: J3.144 (PEX_TX1), R22.2
/MXM_PEX_TX1#: J3.142 (PEX_TX1#), R23.2
/MXM_PEX_TX2: J3.138 (PEX_TX2), R24.2
/MXM_PEX_TX2#: J3.136 (PEX_TX2#), R25.2
/MXM_PEX_TX3: J3.122 (PEX_TX3), R26.2
/MXM_PEX_TX3#: J3.120 (PEX_TX3#), R27.2
/MXM_PEX_TX4: J3.116 (PEX_TX4), R28.2
/MXM_PEX_TX4#: J3.114 (PEX_TX4#), R29.2
/MXM_PEX_TX5: J3.110 (PEX_TX5), R30.2
/MXM_PEX_TX5#: J3.108 (PEX_TX5#), R31.2
/MXM_PEX_TX6: J3.104 (PEX_TX6), R32.2
/MXM_PEX_TX6#: J3.102 (PEX_TX6#), R33.2
/MXM_PEX_TX7: J3.98 (PEX_TX7), R34.2
/MXM_PEX_TX7#: J3.96 (PEX_TX7#), R35.2
/MXM_PWR_EN: J3.8 (PWR_EN), U6.4 (Y)
/MXM_PWR_LEVEL: J3.18 (PWR_LEVEL), U2.4 (Y)
/PERST_N: J1.53 (PERST_N), R41.1
/PEX_STD_SW: J3.19 (PEX_STD_SW#), R36.1
/PNL_BL_EN: J1.62 (PNL_BL_EN), J3.25 (PNL_BL_EN)
/PNL_BL_PWM: J1.72 (PNL_BL_PWM), J3.27 (PNL_BL_PWM)
/PNL_PWR_EN: J1.71 (PNL_PWR_EN), J3.23 (PNL_PWR_EN)
/PROCHOT_N: J1.65 (PROCHOT_N), J3.20 (TH_OVERT#), R8.2
/PRSNT_L: J3.281 (PRSNT_L#), R7.2
/PRSNT_R: J3.2 (PRSNT_R#), R6.2
/PWR_EN: J2.72 (PWR_EN), R19.1, U6.1 (A)
/PWR_GOOD: J2.73 (PWR_GOOD), J3.6 (PWR_GOOD), R13.1, R37.2
/REFCLK_N: J1.51 (REFCLK_N), J3.153 (PEX_REFCLK#)
/REFCLK_P: J1.50 (REFCLK_P), J3.155 (PEX_REFCLK)
/THRM_INT_N: J1.68 (THRM_INT_N), J3.22 (TH_ALERT#), R38.2
/TS_D1N: C46.2, Q1.1 (B), Q1.3 (C), U4.3 (D1-)
/TS_D1P: C46.1, Q1.2 (E), U4.2 (D1+)
/TS_D2N: C47.2, Q2.1 (B), Q2.3 (C), U4.5 (D2-)
/TS_D2P: C47.1, Q2.2 (E), U4.4 (D2+)
GND: C1.2, C2.2, C3.2, C4.2, C42.2, C43.2, C44.2, C45.2, C48.2, D1.2 (A), J1.1 (GND), J1.4 (GND), J1.7 (GND), J1.10 (GND), J1.13 (GND), J1.16 (GND), J1.19 (GND), J1.22 (GND), J1.25 (GND), J1.28 (GND), J1.31 (GND), J1.34 (GND), J1.37 (GND), J1.40 (GND), J1.43 (GND), J1.46 (GND), J1.49 (GND), J1.52 (GND), J2.15 (GND), J2.16 (GND), J2.17 (GND), J2.18 (GND), J2.19 (GND), J2.20 (GND), J2.21 (GND), J2.22 (GND), J2.23 (GND), J2.24 (GND), J2.25 (GND), J2.26 (GND), J2.31 (GND), J2.32 (GND), J2.33 (GND), J2.38 (GND), J2.39 (GND), J2.40 (GND), J2.47 (GND), J2.48 (GND), J2.49 (GND), J2.50 (GND), J2.51 (GND), J2.55 (GND), J2.58 (GND), J2.70 (GND), J3.11 (GND), J3.12 (GND), J3.13 (GND), J3.15 (GND), J3.17 (GND), J3.36 (GND), J3.37 (GND), J3.46 (GND), J3.47 (GND), J3.52 (GND), J3.53 (GND), J3.58 (GND), J3.59 (GND), J3.64 (GND), J3.65 (GND), J3.70 (GND), J3.71 (GND), J3.76 (GND), J3.77 (GND), J3.82 (GND), J3.83 (GND), J3.88 (GND), J3.89 (GND), J3.94 (GND), J3.95 (GND), J3.100 (GND), J3.101 (GND), J3.106 (GND), J3.107 (GND), J3.112 (GND), J3.113 (GND), J3.118 (GND), J3.119 (GND), J3.124 (GND), J3.125 (GND), J3.133 (GND), J3.134 (GND), J3.139 (GND), J3.140 (GND), J3.145 (GND), J3.146 (GND), J3.151 (GND), J3.152 (GND), J3.157 (GND), J3.166 (GND), J3.173 (GND), J3.174 (GND), J3.179 (GND), J3.180 (GND), J3.185 (GND), J3.186 (GND), J3.191 (GND), J3.192 (GND), J3.197 (GND), J3.198 (GND), J3.203 (GND), J3.204 (GND), J3.209 (GND), J3.210 (GND), J3.215 (GND), J3.216 (GND), J3.221 (GND), J3.222 (GND), J3.228 (GND), J3.244 (GND), J3.250 (GND), J3.251 (GND), J3.256 (GND), J3.257 (GND), J3.262 (GND), J3.263 (GND), J3.268 (GND), J3.269 (GND), J3.275 (GND), J3.E3 (GND), J3.E4 (GND), J4.4 (GND), J4.MP, J5.4 (GND), J5.MP, R1.2, R2.2, R14.2, R16.2, R17.2, R18.2, R19.2, R36.2, R39.2, U1.4 (GND), U1.5 (GND), U1.12 (LDSTRT), U1.14 (GND), U1.26 (GND), U2.3 (GND), U3.1 (A0), U3.2 (A1), U3.3 (A2), U3.4 (VSS), U3.7 (WP), U4.6 (GND), U6.3 (GND)
PWR_SRC: C4.1, J3.E1 (PWR_SRC), J3.E2 (PWR_SRC), U1.17 (OUT), U1.18 (OUT), U1.19 (OUT), U1.20 (OUT), U1.21 (OUT), U1.22 (OUT), U1.23 (OUT), U1.24 (OUT)
VSYS: C1.1, D1.1 (K), J2.1 (VSYS_GPU), J2.2 (VSYS_GPU), J2.3 (VSYS_GPU), J2.4 (VSYS_GPU), J2.5 (VSYS_GPU), J2.6 (VSYS_GPU), J2.7 (VSYS_GPU), J2.8 (VSYS_GPU), J2.9 (VSYS_GPU), J2.10 (VSYS_GPU), J2.11 (VSYS_GPU), J2.12 (VSYS_GPU), J2.13 (VSYS_GPU), J2.14 (VSYS_GPU), R15.1, U1.1 (IN), U1.2 (IN), U1.3 (IN), U1.16 (IN), U1.25 (IN)

Notes on the sheet:
EC MODULE-DETECTION + PULL-UPS (330k IDs work per forum t/74018 OP; other values from MXM 3.1, the FW16 interface schematic and the community board)
PWR_LEVEL: battery -> reduced card power (GPIO2_EC = AC present)
EEPROM: blank = EC defaults to dual-SSD (x4x2) and never enables VSYS. Program PCIE_THERMAL_3RDPARTY (PCIE_8X1, VSYS_EN, FAN_EN, 3V_5V_EN, F75303 @0x4D),
but set GPU_PCIE_MUX_SEL LOW so DP_A AUX is not rerouted to SSD2 CLK. Note: EC sets GPU_PRESENT (eDP mux path) only for vendor GPU_AMD_R23M.
POWER: VSYS -> TVS D1 -> eFuse U1 (TPS25982, ~9.9 A limit) -> PWR_SRC to the MXM card; +5V / +3V3 from host 5V_ALW (2.5A max) / 3V3_ALW (2.0A max)
J2 POWER INTERPOSER (pinout: FrameworkComputer/ExpansionBay)
PWR_EN: 1.8 V host GPIO AND eFuse PG -> 3.3 V card PWR_EN
FAN HEADERS - host EC drives 12V_FAN / PWM (5 V) and reads SPEED (5 V OD). Pinout per FW ref PCB drawing.
FAN-CONTROL TEMP SENSOR - F75303 @0x4D on the ALW I2C bus (Framework PCIE_THERMAL_3RDPARTY descriptor). Pins per FW16 7040 interface schematic p.9.
FW16 EXPANSION BAY -> MXM 3.x ADAPTER | schematic v4 DRAFT | generated + ERC-checked with KiCad 10 (kicad-cli)
NOT A MANUFACTURABLE DESIGN. No PCB layout. Every value/pin/footprint marked TBD is an unresolved placeholder (see BOM CSV).
J1/J2 pins: github.com/FrameworkComputer/ExpansionBay Electrical/README.md ; J3: MXM 3.1 connector tables (ADLINK MXM-AXe, Advantech SKY-MXM-RTX3000).
Lanes go straight through by name: host PEX_TX -> MXM PEX_TX (MXM names are system-relative; confirmed by MXM 3.1 Table 3.6).
Series parts: host->card PCIe R20-R35 = 0R; card->host PCIe C10-C25 = 220nF; DP_A lanes+AUX C26-C35 = 100nF DC blocking; HPD direct (R14 pull-down DNP).
OPEN: TH_PWM unconnected. J3 = S55B on a 1.2 mm adapter; needs the flat 3D-printed bay cover (15.3 mm inside). Pins 52/53 and the F75303 address per FW16 7040 interface schematic. Checked against MXM 3.1 r1.0.

Board: 6 copper layers, 92 parts (0 on the bottom side), 129 nets, no tracks yet.

Other parts of the board:
H1: MountingHole_2.2mm_M2
H2: MountingHole_2.7mm
H3, H4: MXM card hold-down (Type A and B); MountingHole_2.2mm_M2
