PCModder803/fw16-mxm-adapter/generate_pcb.py

#!/usr/bin/env python3
"""Generate fw16_mxm_adapter.kicad_pcb: a MECHANICAL PLACEMENT DRAFT (not for fab).

Run with KiCad's Python (it needs the pcbnew module):
    "C:/Program Files/KiCad/10.0/bin/python.exe" generate_pcb.py

What it does:
  - board outline from reference/fw_7700s_board_outline.csv (Framework's RX 7700S module board, read from
    FW_GRAPHICS_MODULE_REF_00-1.stp), extended on the left, rear and front-left for the MXM socket;
  - J1/J2 (interposers), J3 (MXM socket), J4/J5 (fan FPC connectors) and the mounting features placed;
  - every other part from the schematic netlist placed in a staging grid beside the board, with nets,
    so the ratsnest shows;
  - reference drawings on User layers: MXM card outline, interposer-stiffener keep-out, and the walls and
    keep-outs of the printed bottom frame (FRAME_PLAN.md, generate_frame.py).
No tracks. Coordinates: u across the bay, v toward the laptop edge, origin midway between the two
interposer screws (RESEARCH_TODO item 7b). KiCad X = X0 + u, Y = Y0 + v (top view, laptop edge at the
bottom of the screen).
"""
import json, math, os, subprocess, sys, tempfile
import xml.etree.ElementTree as ET
import pcbnew

HERE = os.path.dirname(os.path.abspath(__file__))
KICAD = os.path.dirname(sys.executable)                      # .../KiCad/10.0/bin
STOCK = os.path.join(os.path.dirname(KICAD), "share", "kicad", "footprints")
PROJ_LIB = os.path.join(HERE, "fw16_mxm.pretty")
OUT = os.path.join(HERE, "fw16_mxm_adapter.kicad_pcb")
X0, Y0 = 150.0, 110.0
mm = pcbnew.FromMM

def P(u, v): return pcbnew.VECTOR2I(mm(X0 + u), mm(Y0 + v))

from layout import *              # placement decisions and the board outline (shared with generate_frame.py)

def add_outline(board):
    for sh in outline_shapes():
        s = pcbnew.PCB_SHAPE(board)
        s.SetLayer(pcbnew.Edge_Cuts); s.SetWidth(mm(0.1))
        if sh[0] == "line":
            s.SetShape(pcbnew.SHAPE_T_SEGMENT); s.SetStart(P(*sh[1])); s.SetEnd(P(*sh[2]))
        else:
            s.SetShape(pcbnew.SHAPE_T_ARC); s.SetArcGeometry(P(*sh[1]), P(*sh[2]), P(*sh[3]))
        board.Add(s)

def rect(board, layer, box, width=0.15):
    u0, v0, u1, v1 = box
    for a, b in (((u0, v0), (u1, v0)), ((u1, v0), (u1, v1)), ((u1, v1), (u0, v1)), ((u0, v1), (u0, v0))):
        s = pcbnew.PCB_SHAPE(board); s.SetShape(pcbnew.SHAPE_T_SEGMENT); s.SetLayer(layer)
        s.SetWidth(mm(width)); s.SetStart(P(*a)); s.SetEnd(P(*b)); board.Add(s)

def poly(board, layer, pts, width=0.15):
    for a, b in zip(pts, pts[1:]):
        s = pcbnew.PCB_SHAPE(board); s.SetShape(pcbnew.SHAPE_T_SEGMENT); s.SetLayer(layer)
        s.SetWidth(mm(width)); s.SetStart(P(*a)); s.SetEnd(P(*b)); board.Add(s)

def text(board, layer, u, v, msg, size=1.2):
    t = pcbnew.PCB_TEXT(board); t.SetText(msg); t.SetLayer(layer); t.SetPosition(P(u, v))
    t.SetTextSize(pcbnew.VECTOR2I(mm(size), mm(size))); t.SetTextThickness(mm(size * 0.15))
    t.SetHorizJustify(pcbnew.GR_TEXT_H_ALIGN_LEFT); board.Add(t)

# ------------------------------------------------------------------ netlist from the schematic
def netlist():
    tmp = os.path.join(tempfile.mkdtemp(), "net.xml")
    subprocess.run([os.path.join(KICAD, "kicad-cli"), "sch", "export", "netlist", "--format", "kicadxml",
                    "--output", tmp, os.path.join(HERE, "fw16_mxm_adapter.kicad_sch")], check=True,
                   stdout=subprocess.DEVNULL)
    root = ET.parse(tmp).getroot()
    comps = {c.get("ref"): (c.findtext("value"), c.findtext("footprint")) for c in root.iter("comp")}
    pinnet = {}
    for n in root.iter("net"):
        for node in n.iter("node"):
            pinnet[(node.get("ref"), node.get("pin"))] = n.get("name")
    return comps, pinnet

def load_fp(fpid):
    lib, name = fpid.split(":")
    path = PROJ_LIB if lib == "fw16_mxm" else os.path.join(STOCK, lib + ".pretty")
    fp = pcbnew.FootprintLoad(path, name)
    if fp is None: raise SystemExit(f"footprint not found: {fpid}")
    fp.SetFPIDAsString(fpid)
    return fp

def main():
    board = pcbnew.BOARD()
    ds = board.GetDesignSettings()
    ds.SetBoardThickness(mm(BOARD_THICKNESS))
    ds.m_CopperEdgeClearance = mm(0.3)       # JLCPCB's minimum for a routed edge; J3's rear ear pad uses it
    board.SetCopperLayerCount(COPPER_LAYERS)
    tb = board.GetTitleBlock()
    tb.SetTitle("FW16 Expansion Bay to MXM adapter - mechanical placement draft")
    tb.SetRevision("draft-2"); tb.SetDate("2026-11-11")
    tb.SetComment(0, "NOT FOR FAB: placement and fit study only, no routing")
    tb.SetComment(1, "Outline from Framework's RX 7700S module board (FW_GRAPHICS_MODULE_REF_00-1.stp, CC BY 4.0)")
    tb.SetComment(2, "Generated by generate_pcb.py - edit the script, not this file")

    add_outline(board)
    comps, pinnet = netlist()
    nets = {}
    for name in sorted(set(pinnet.values())):
        ni = pcbnew.NETINFO_ITEM(board, name); board.Add(ni); nets[name] = ni

    fixed = {
        "J1": (0.0, 0.0, 0), "J2": (0.0, 0.0, 0),          # same XY: the two halves of one interposer pair
        "J3": (J3_U, J3_V, 90),
        "J4": (J4_UV[0], J4_UV[1], 0), "J5": (J5_UV[0], J5_UV[1], 0),
    }
    stage_u, stage_v, col = 75.0, -85.0, 0
    for ref in sorted(comps, key=lambda r: (r.rstrip("0123456789"), int("0" + "".join(ch for ch in r if ch.isdigit())))):
        value, fpid = comps[ref]
        fp = load_fp(fpid)
        fp.SetReference(ref); fp.SetValue(value or "")
        board.Add(fp)
        if ref in fixed:
            u, v, rot = fixed[ref]
            fp.SetPosition(P(u, v)); fp.SetOrientationDegrees(rot)
        else:
            fp.SetPosition(P(stage_u + (col % 6) * 12.0, stage_v + (col // 6) * 8.0)); col += 1
        for pad in fp.Pads():
            n = pinnet.get((ref, pad.GetNumber()))
            if n: pad.SetNet(nets[n])

    # J3 direction check: the card side of the socket (footprint +y) must face +u.
    j3 = next(f for f in board.GetFootprints() if f.GetReference() == "J3")
    p1 = next(p for p in j3.Pads() if p.GetNumber() == "1")          # footprint y = +3.75 row
    p2 = next(p for p in j3.Pads() if p.GetNumber() == "2")          # footprint y = -3.50 row
    if p1.GetPosition().x < p2.GetPosition().x:
        j3.SetOrientationDegrees(270)

    # MXM card hold-downs (Foxconn drawing: dia 6.8 keepouts at footprint x +-37.5, y +66): M2 standoffs,
    # card gap tall. Positions follow J3's placement. The same two holes take Type A and Type B cards.
    for i, lx in enumerate((-37.5, 37.5)):
        t = math.radians(j3.GetOrientationDegrees())      # KiCad: Y down, positive angle = CCW on screen
        qx = lx * math.cos(t) + 66.0 * math.sin(t); qy = -lx * math.sin(t) + 66.0 * math.cos(t)
        pos = pcbnew.VECTOR2I(j3.GetPosition().x + mm(qx), j3.GetPosition().y + mm(qy))
        fp = load_fp("MountingHole:MountingHole_2.2mm_M2"); fp.SetReference(f"H{3 + i}"); fp.SetValue("MXM card hold-down (Type A and B)")
        fp.SetPosition(pos); board.Add(fp)
        c = pcbnew.PCB_SHAPE(board); c.SetShape(pcbnew.SHAPE_T_CIRCLE); c.SetLayer(pcbnew.Dwgs_User); c.SetWidth(mm(0.15))
        c.SetCenter(pos); c.SetEnd(pcbnew.VECTOR2I(pos.x + mm(3.4), pos.y)); board.Add(c)

    # mounting features
    for (u, v), fpid, ref in ((MOUNT_SCREW, "MountingHole:MountingHole_2.2mm_M2", "H1"),
                              (REAR_INSERT, "MountingHole:MountingHole_2.7mm", "H2")):
        fp = load_fp(fpid); fp.SetReference(ref); fp.SetPosition(P(u, v)); board.Add(fp)

    # reference drawings
    U1, U2, CM = pcbnew.Dwgs_User, pcbnew.Cmts_User, pcbnew.Eco1_User
    rect(board, U1, CARD, 0.2)
    text(board, U1, CARD[0] + 2, CARD[1] + 4, f"MXM CARD TYPE B 105 x 82 (underside {CARD_GAP} mm above board, S55B)")
    poly(board, U1, [(CARD_A[2], CARD_A[1]), (CARD_A[2], CARD_A[3])], 0.15)
    text(board, U1, CARD_A[0] + 2, CARD_A[1] + 6, "TYPE A 70 x 82 ends here (same socket and hold-downs H3/H4)", 1.0)
    rect(board, U1, STIFFENER, 0.2)
    text(board, U1, STIFFENER[0], STIFFENER[1] - 1.5, "INTERPOSER STIFFENER: 4.45 mm above board top - card must not overlap", 1.0)
    poly(board, U2, WALLS, 0.3)
    text(board, U2, -72.3, -94.3, f"PRINTED FRAME INNER WALLS AT BOARD LEVEL (Framework model, lengthened {REAR_STRETCH} mm at the rear)", 1.0)
    for u, v in COVER_BOSSES:
        c = pcbnew.PCB_SHAPE(board); c.SetShape(pcbnew.SHAPE_T_CIRCLE); c.SetLayer(U2); c.SetWidth(mm(0.3))
        c.SetCenter(P(u, v)); c.SetEnd(P(u + 3.0, v)); board.Add(c)
        text(board, U2, u - 3.0, v - 4.0, "COVER BOSS (frame) to 5.0 mm", 0.8)
    for box, label in KEEPOUTS:
        rect(board, U2, box, 0.3)
        text(board, U2, box[0] + 0.5, box[1] - 1.0, label, 0.8)
    text(board, CM, -66, 14, "MECHANICAL PLACEMENT DRAFT - NOT FOR FAB. Parts right of the board are unplaced (staging).", 1.5)
    text(board, CM, -66, 17.5, f"Laid out for the printed bottom frame (FRAME_PLAN.md), {REAR_STRETCH} mm longer at the rear: J3's rear end fits inside.", 1.5)
    text(board, CM, -66, 21, "Not checked yet: J4/J5 orientation, interposer footprint details, the lid's clearance to the longer rear.", 1.5)

    board.Save(OUT)
    # KiCad takes board rules from the project file, so record the edge clearance there too.
    pro = os.path.splitext(OUT)[0] + ".kicad_pro"
    cfg = json.load(open(pro, encoding="utf-8")) if os.path.exists(pro) else {"meta": {"version": 1}}
    cfg.setdefault("board", {}).setdefault("design_settings", {}).setdefault("rules", {})["min_copper_edge_clearance"] = 0.3
    with open(pro, "w", encoding="utf-8", newline="\n") as fh:
        json.dump(cfg, fh, indent=2); fh.write("\n")
    print("wrote", OUT, "footprints:", len(board.GetFootprints()))

if __name__ == "__main__":
    main()
