PCModder803/fw16-mxm-adapter/(commit log)

2026-11-09 FW16 Expansion Bay to MXM 3.0 Type B adapter: schematic v4
    Generated KiCad schematic (generate_schematic.py), footprint library,
    BOM draft, schematic PDF, research notes and card/bay photos.
    Target card: X-Vision RX 6600 XT, S55B socket on a 1.2 mm adapter.
    [fw16_mxm_adapter.kicad_sch, fw16_mxm_adapter_bom_draft.csv, interposer_compare.csv, mxm_j1_pads.csv]
2026-11-09 Clean up public repo: sources, stale figures, photo metadata
    - Cite the F75303M pinout, filter caps and address to Framework's public
    7040 mainboard interface schematic (p.9) instead of a third-party laptop
    schematic.
    - Strip camera metadata from the photos (lossless; orientation kept).
    - Stop tracking reference/analysis/ (intermediate data derived from the
    community board file).
    - Fix stale or inconsistent figures: flat-cover height table (inductor tops
    = underside + 6.4 mm, add the chosen 1.2 mm row), card PCB thickness,
    USB-C offset and C1/C4 under-card gap for the 1.2 mm board, part count 88.
    - Note the ID pull-up discrepancy (3.3 V via 100k would miss the window,
    yet 330k is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
    [fw16_mxm_adapter.kicad_sch, fw16_mxm_adapter_bom_draft.csv, interposer_compare.csv, mxm_j1_pads.csv]
2026-11-09 RESEARCH_TODO: layout plan (JLCPCB) and test-board measurements
2026-11-11 Record Framework PCIe test board (EFXDP1 riser) measurements
    Board size and thickness, insert side, mounting-hole offsets from the
    interposer pair, plus the riser photo and a copy with the holes lettered.
    Photo metadata stripped (orientation kept).
2026-11-11 RESEARCH_TODO: note the 17.0 mm interposer-hole reading
2026-11-11 RESEARCH_TODO: riser holes A/D/F confirmed, measured to centres
2026-11-11 RESEARCH_TODO: riser mounting holes match the fan-board drawing
2026-11-11 Add 7700S module board outline and fixings from Framework's STEP
    Read FW_GRAPHICS_MODULE_REF_00-1.stp (FrameworkComputer/ExpansionBay,
    CC BY 4.0) with a small script: board outline as CSV in interposer-centred
    coordinates, interposer insert spacing (16.65 mm), shell posts (41.0 mm
    c-c), board fixings and heights. The STEP itself stays out of the repo.
    [fw_7700s_board_outline.csv]
2026-11-11 Add mechanical placement draft PCB (not for fab)
    generate_pcb.py builds fw16_mxm_adapter.kicad_pcb with KiCad's pcbnew:
    7700S module outline extended for the MXM socket, interposers, socket,
    fan connectors and fixings placed, all other parts staged with nets,
    and user-layer drawings of the card, the interposer stiffener keep-out
    and the shell walls. Shows the open conflict: with S55B the socket's
    rear end overruns the shell's rear wall by ~1.6 mm (RESEARCH_TODO 7b).
    [fw16_mxm_adapter.kicad_pcb]
2026-11-11 Check MXM socket against Foxconn's drawing; map shell conflicts
    - MXM footprint: all pad positions match Foxconn's AS-series recommended
    layout; peg holes set to its 1.10/1.60 mm, courtyard added, mask bridges
    allowed between the staggered pads, small local clearance on the
    merged power pads.
    - Draft: card hold-downs H3/H4 at the drawing's 66 mm points, socket moved
    clear of the left cover-screw boss, shell keep-outs drawn (cover-screw
    bosses, front-left frame ledge, fan cables).
    - RESEARCH_TODO 7b: the 107 mm is the gap between the cover-screw bosses;
    with the stock shell the socket lacks ~2.6 mm along the edge and
    card + socket lack ~2.7 mm across. Options listed.
    Co-Authore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
    [fw16_mxm_adapter.kicad_pcb]
2026-11-11 Plan a printed bottom frame; correct the socket's length
    The stock shell's rear wall is only 1.3-1.6 mm thick and is the laptop's rear
    surface, so with the 5.5 mm socket (card pinned behind the interposer
    stiffener) no shell modification makes room. FRAME_PLAN.md plans a printed
    bottom frame (outside copied from Framework's model, inside redrawn) with the
    7.8 mm socket, lists the frame's inside features from the STEP, and sets out
    the open checks.
    Foxconn's drawing puts the ear pads' centres 3.00 mm past the pegs, so the
    copper spans 91.0 mm and the body 88.9 mm, not 88 mm; notes corrected.
    [fw16_mxm_adapter.kicad_pcb]
2026-11-11 Printed bottom frame mockup; move the PCB draft to it
    generate_frame.py takes Framework's bottom frame (IFGP6_DIS_FRAME_BTM) out of
    their graphics-module STEP and changes the inside for the adapter:
    - a 3.7 mm pocket in the rear wall behind the MXM socket;
    - the cover-screw bosses moved outboard;
    - the rear-wall ribs trimmed;
    - two frame pins and a front-left lip removed;
    - one locating pin cut flush.
    It checks the result against the board, socket and card, which are all
    clear, and writes mechanical/printed_frame_mockup.step and .stl (CC BY 4.0,
    credited to Framework).
    The socket stays S55B: with S78B the card's front hold-down would land on
    the interposer stiffener, which needs the socket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
    [fw16_mxm_adapter.kicad_pcb, printed_frame_mockup.step, printed_frame_mockup.stl]
2026-11-12 Lengthen the printed frame's whole rear instead of a pocket; repo check
    The frame is now stretched 3.7 mm over its full width just in front of the
    rear wall (layout.REAR_STRETCH), so the rear face stays straight with the
    stock vents and corners, and there is 5.1 mm behind the card for heat pipes.
    The fit check still passes and the STL is watertight. PCB draft notes and
    frame walls follow.
    Final pass over the docs: stale notes in RESEARCH_TODO (shell on order,
    Foxconn checks already done, old DRC summary), the J3 BOM note, and the
    README's verification line.
    [fw16_mxm_adapter.kicad_pcb, fw16_mxm_adapter_bom_draft.csv, printed_frame_mockup.step, printed_frame_mockup.stl]
2026-11-12 Mark Type A card support on the PCB draft
    Type A (82 x 70) cards use the same socket, finger edge and hold-downs as
    Type B: the card's side holes sit 66 mm from the fingers on both types, so
    H3/H4 already take either. The draft now draws where a Type A card ends,
    and the README and research notes say so.
    [fw16_mxm_adapter.kicad_pcb]
