PCModder803/fw16-mxm-adapter/reference/card_photos/1000010391.jpg

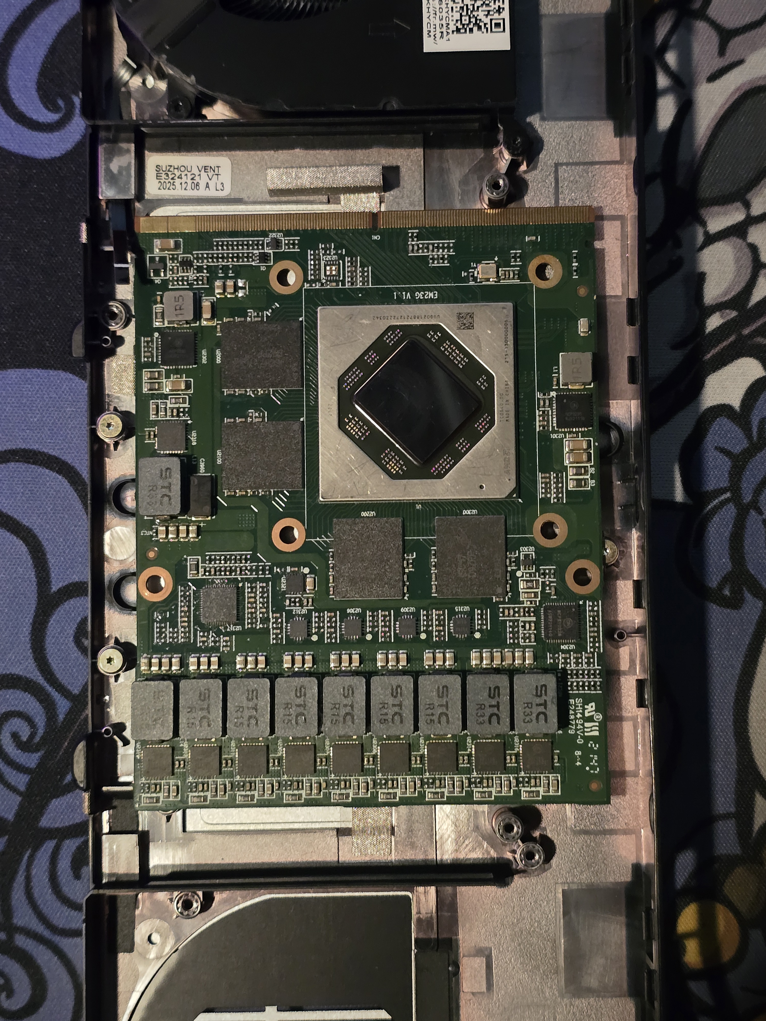
reference/card_photos/1000010391.jpg
